ic3e/Begode-master/README.md

# Begode Master: front handle and self-levelling headlamp

3D-printable parts for the Begode Master electric unicycle:

- **Front handle:** built on the community handle (`reference/euc_master_front_handle.stl`), with every
  original bolt hole kept where it was, and a sealed USB-C phone charger in one leg.
- **Self-levelling headlamp:** fills the stock lamp's opening in the top cover. It has:
  - three fixed LEDs; a servo tilts a frame with their three lenses ±10°, so the beam stays put while the
    wheel pitches (about 1000–1100 lm)
  - a road sensor behind the window, so the beam follows hills too (an EUC stays level on a hill; the gyro alone
    can't see one)
  - two riding buttons on the handle's leg: dip the beam for oncoming traffic, high beam, flash
  - sealed against rain, tyre spray and sand: the cooling air has its own drained duct, everything else is dry
  - daytime running lights and day/night switching
  - two buttons in the chin for every setting, so no phone or app is needed (a Wi-Fi page is there if you want it)
  - a USB-C phone charger in the handle, with a power guard so the lamp and charger stay inside the wheel's lamp output
  - beam brightness that follows the wheel's lamp voltage (6.5 V dim, 12 V full)
  - a flush clear window and angled running-light lines that follow the Master's faceted front
  - drop-safe: whichever way the wheel falls, the handle, shells or tyre touch the ground first (lamp at least
    20 mm clear), and hard stops inside so a drop doesn't load the servo's gears

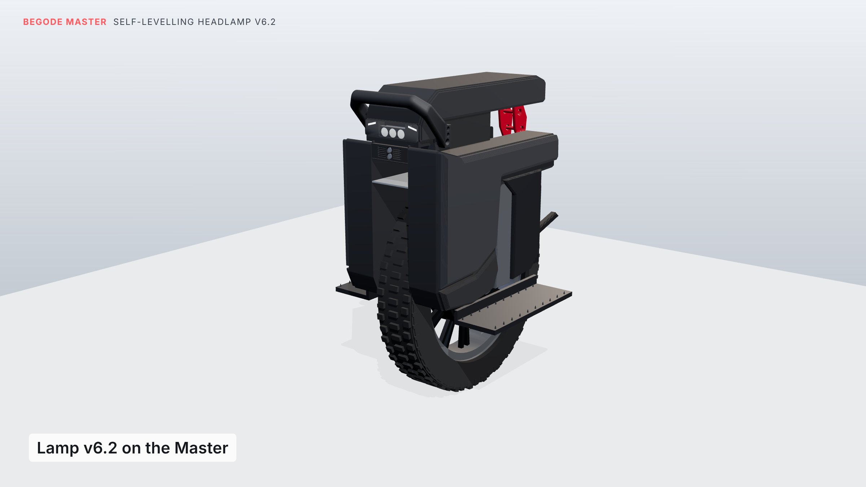
[picture p1: current/renders/render_v62_hero.png]
Lamp v6.2 in the stock opening

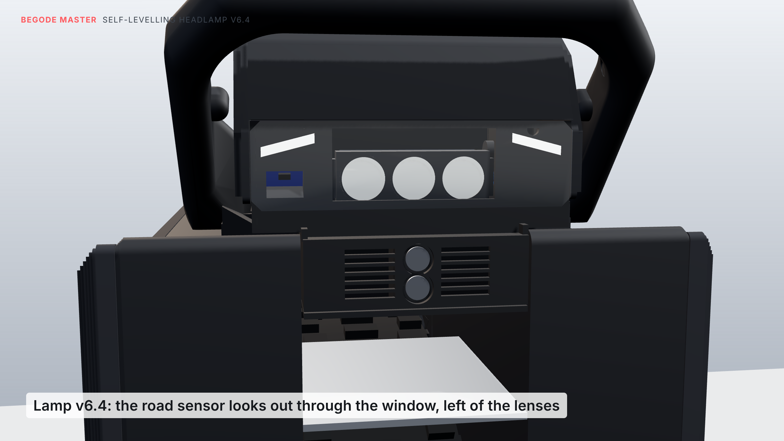
[picture p2: current/renders/render_v64_face.png]
Lamp v6.4: the road sensor's eye left of the lenses


## What to print now

Everything is in [`current/`](current). [`current/BUILD_GUIDE.md`](current/BUILD_GUIDE.md) has:

- the parts list
- which LEDs, optics, heat sink and electronics to buy, and the wiring
  (prices and shops in [`current/PARTS.md`](current/PARTS.md), about €115–170)
- hardware and assembly order
- the buttons (chin and handle) and the USB charger
- the firmware
- everything that was checked

[`current/TESTING.md`](current/TESTING.md) is the test plan and log for rides, rough roads, drops and rain.

| Folder | Contents |
|---|---|
| `current/stl/` | handle v18 (USB port and riding buttons on the right or left), the two bolt covers (right and left), lamp housing, top plate, lens frame, lid, and the window's cutting template (SVG), each lying on the bed as it should print |
| `current/firmware/headlamp6_firmware/` | ESP32-C3 firmware (Arduino; needs the Pololu "VL53L1X" library) |
| `current/renders/` | stills: day, night, face on, fallen forward / onto its side; how the head is fitted, the stops, the buttons and the USB port |
| `reference/` | the original handle and cap STLs, the measurement sheets, and [`MEASUREMENTS.md`](reference/MEASUREMENTS.md) (every measurement taken on the wheel) |
| `source/` | the Python scripts that build, check, export and render every version (see [`source/README.md`](source/README.md)) |
| `archive/` | all earlier versions: guides, STLs, firmware, renders, including v8 with the swing-up can holder and its animation |

**Only `current/` fits the real wheel.** Handles v4 to v9 were drawn on a wheel model traced from photos.
They run into the shells and the top cover, so don't print them. From v10 on, everything is checked
against a model built from caliper measurements.

## Version history

| Guide | Handle | What changed |
|---|---|---|
| — | v1 | cup ring that folds up beside the handle |
| — | v2 | cup ring on hinges at the handle's front corners |
| — | v3–v5 | motorcycle-style folding cup holder; holder for the stock lamp (estimated) |
| headlamp v1 | v5 | self-levelling servo head (ESP32-C3 + MPU-6050) |
| headlamp v2 | v5 | road sensor (VL53L1X), daytime running lights, light sensor, Wi-Fi settings |
| headlamp v3 | v6 | follows the wheel's 6.5 / 12 V lamp output; lamp and cup holder as one unit |
| v4 | v7 | minimal ring that folds under the lamp, with a fold-flat foot |
| v5 | v8 | slide-out self-levelling cup holder (forward/back) |
| v6 | v9 | two-axis gimbal (forward/back and side to side) |
| v7 | v10 | rebuilt to caliper measurements; lamp in front of the cover; can holder swings up into the bay |
| v8 | v11 | lamp built into the stock lamp opening; extra mounting through the cover's two M4 screws |
| lamp v5 | v12 | no can holder; three LEDs on one tilting bar (~1200 lm); electronics box between the shells |
| lamp v5.1 | v12 | flush polycarbonate window, angled running-light lines, chin vent and baffle, checked for drops |
| lamp v5.2 | v12 | open-top housing with a screwed-on top plate, so the head and servo can actually be fitted |
| lamp v5.3 | v12 | sealed 6800 ball bearing for the head's pivot; wire hole on the pin's axis |
| lamp v5.4 | v13 | hard stops for the head; chin buttons instead of the phone page; USB-C charger in the handle with a power guard; firmware v6 |
| lamp v6 | v13 | sealed against rain, tyre spray and sand: LEDs fixed on a heat sink in a separate air duct, only a lens frame tilts |
| lamp v6.1 | v13 | fewer parts: no road sensor, no heat-sink clamp, no diffusers, no gasket |
| lamp v6.2 | v14 | ready for the slicer: no thin walls, slits or trapped supports; parts exported in their print orientation; horn glued |
| lamp v6.2 | v15 | the USB-C port flush in the handle's leg, no bump: a bare receptacle potted in epoxy, with a silicone plug |
| lamp v6.2 | v16 | the USB-C port on the leg's inside, out of the way in a side fall; pressed in from inside, no pocket to fill |
| lamp v6.2 | v17 | the lamp tabs braced (the first print snapped them): a gusset under each and a fillet over its root; the USB wire inside the root, not in a groove along it |
| lamp v6.3 | v17 | every board fitted at its real size; wire slots from the side bays into the electronics box; wiring diagram and board renders |
| **lamp v6.4** | **v18** | **a road sensor (VL53L1X) behind the window so the beam follows hills; two riding buttons on the handle's leg that dip, raise and flash the beam (cut-off lenses don't fit the opening)** |

## Rebuilding

Python 3 with `numpy`, `trimesh`, `manifold3d` and `matplotlib`. Run from `source/`:

```
cd source && mkdir -p ../build_output
python3 check28.py     # every fit / clearance / assembly / sealing / drop check for the current version
python3 export28.py    # writes the current STLs and the window SVG to current/stl/, lying as they print
python3 boards_pack.py # fits the boards into the dry spaces (then boards_export.py, wiring_diagram.py)
python3 print_check.py # what a slicer would see in them: closed solids, thin walls, slits, supports
```

Stills (three.js in headless Chromium, as for the animation):

```
python3 stills6_export.py              # writes anim/stills6_data.js
cd anim && npm install
python3 -m http.server 8766 --bind 127.0.0.1 &
PAGE=stills6.html OUTD=stills6 node stills_render.mjs   # anim/stills6/f0000.png …
```

To re-render the v8 animation, see `source/README.md`.

Coordinates throughout are the handle STL's own frame: −X forward, +Y up, Z across the wheel (centre Z = −70.5).
