ic3e/Begode-master/current/renders/boards_4.png

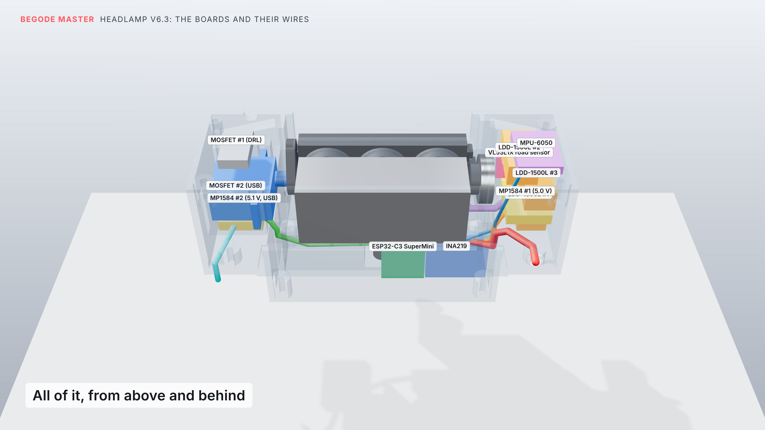
current/renders/boards_4.png
