ic3e/Begode-master/current/renders/concept_projector_rig.png

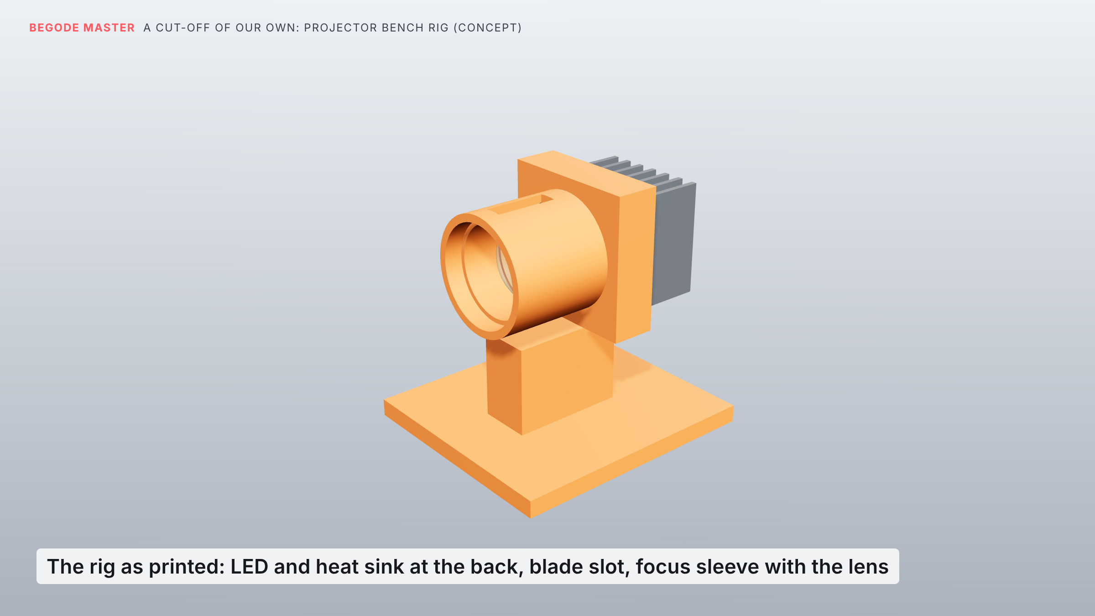
current/renders/concept_projector_rig.png
