ic3e/Begode-master/current/renders/level_accelerating.png

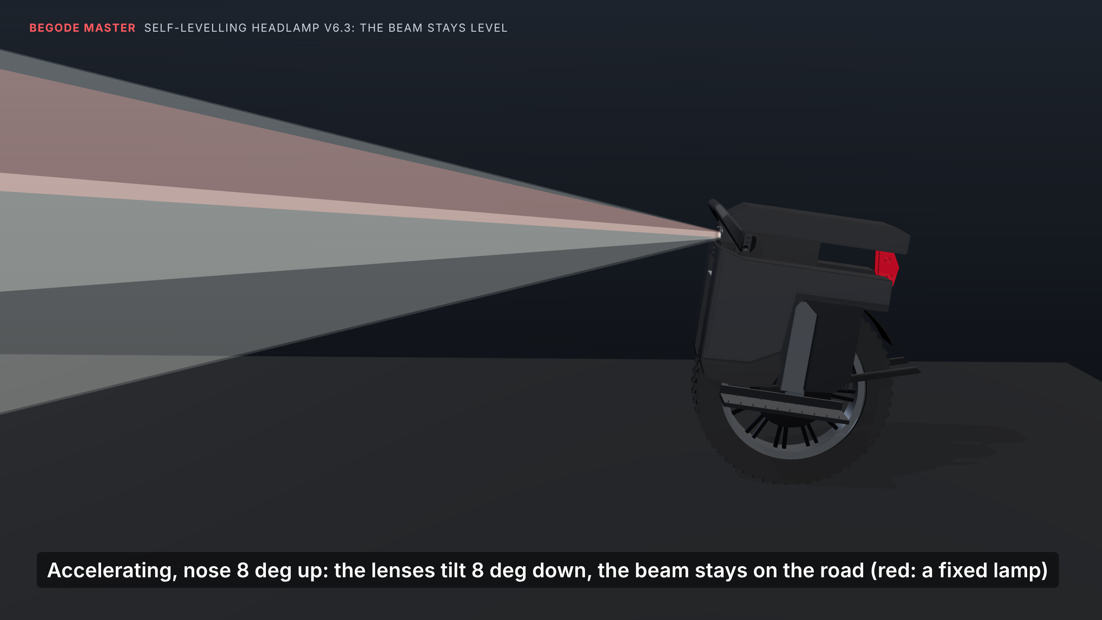
current/renders/level_accelerating.png
