ic3e/Begode-master/current/renders/level_riding.png

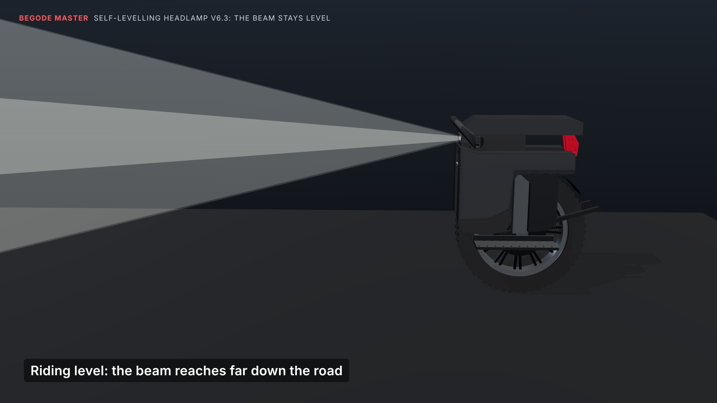
current/renders/level_riding.png
