ic3e/Begode-master/current/renders/render_v8_front.png

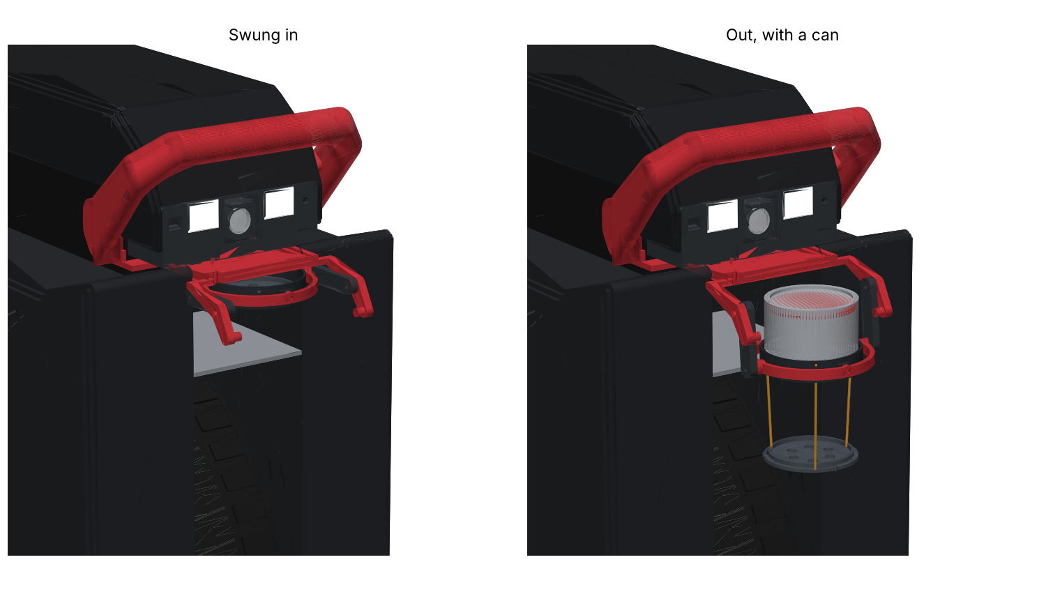
current/renders/render_v8_front.png
