ic3e/Begode-master/current/renders/render_v8_lean.png

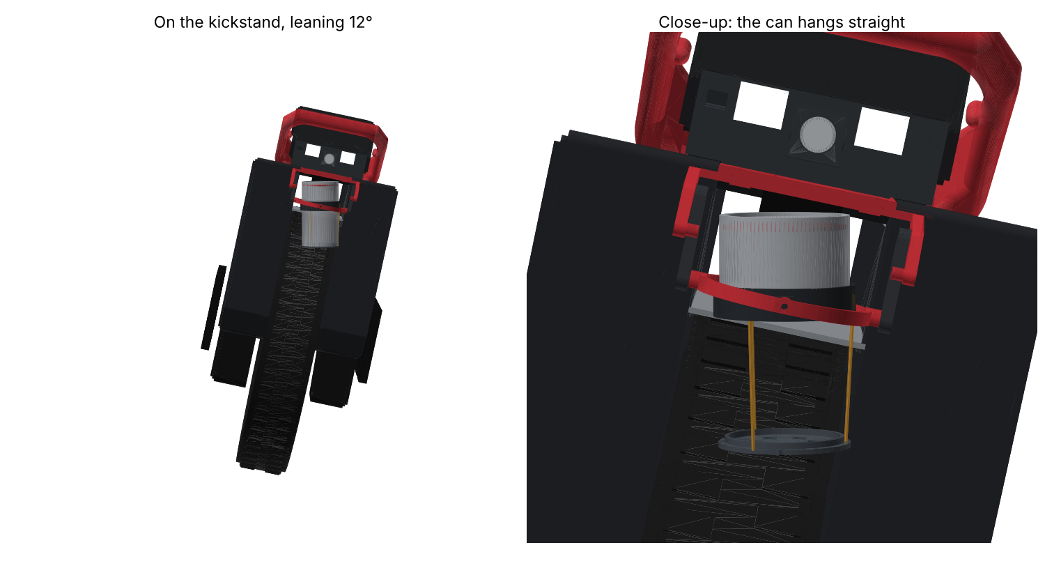
current/renders/render_v8_lean.png
