ic3e/Begode-master/current/renders/render_v8_side.png

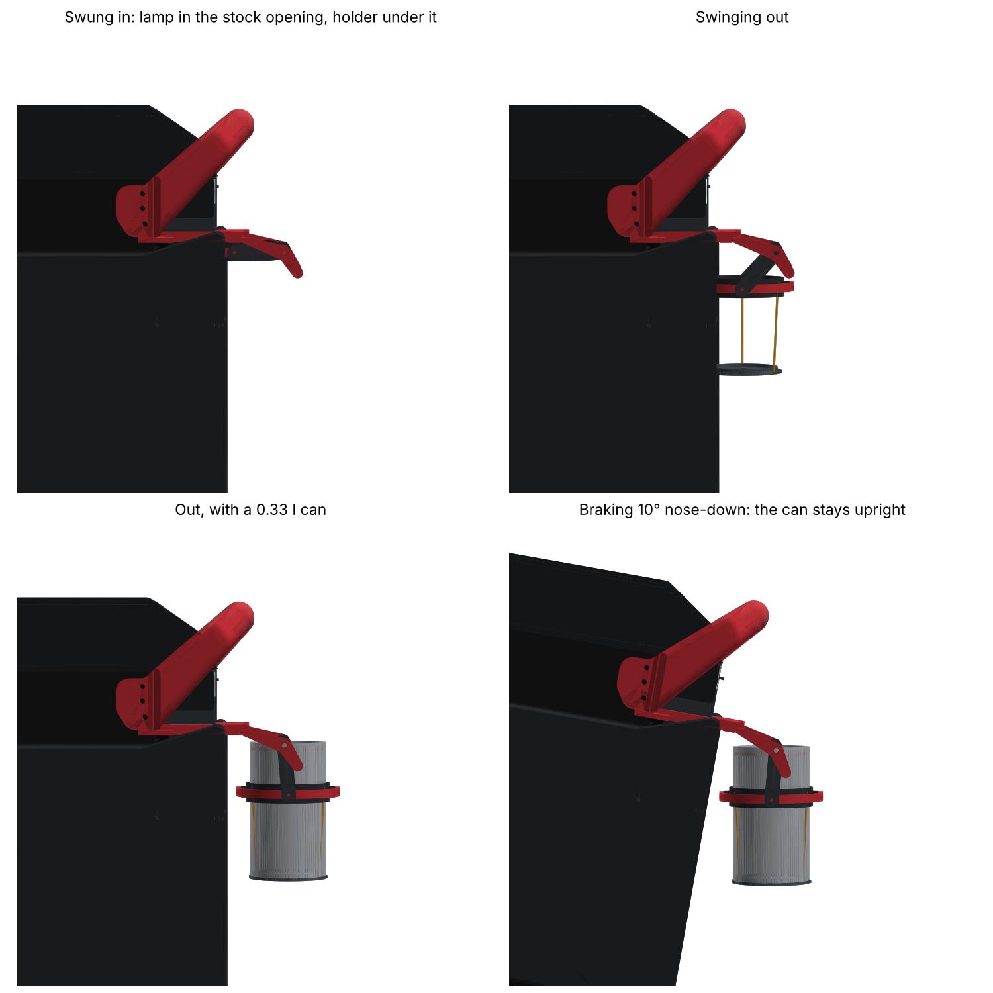
current/renders/render_v8_side.png
