ic3e/Begode-master/current/renders/render_v9_lamp.png

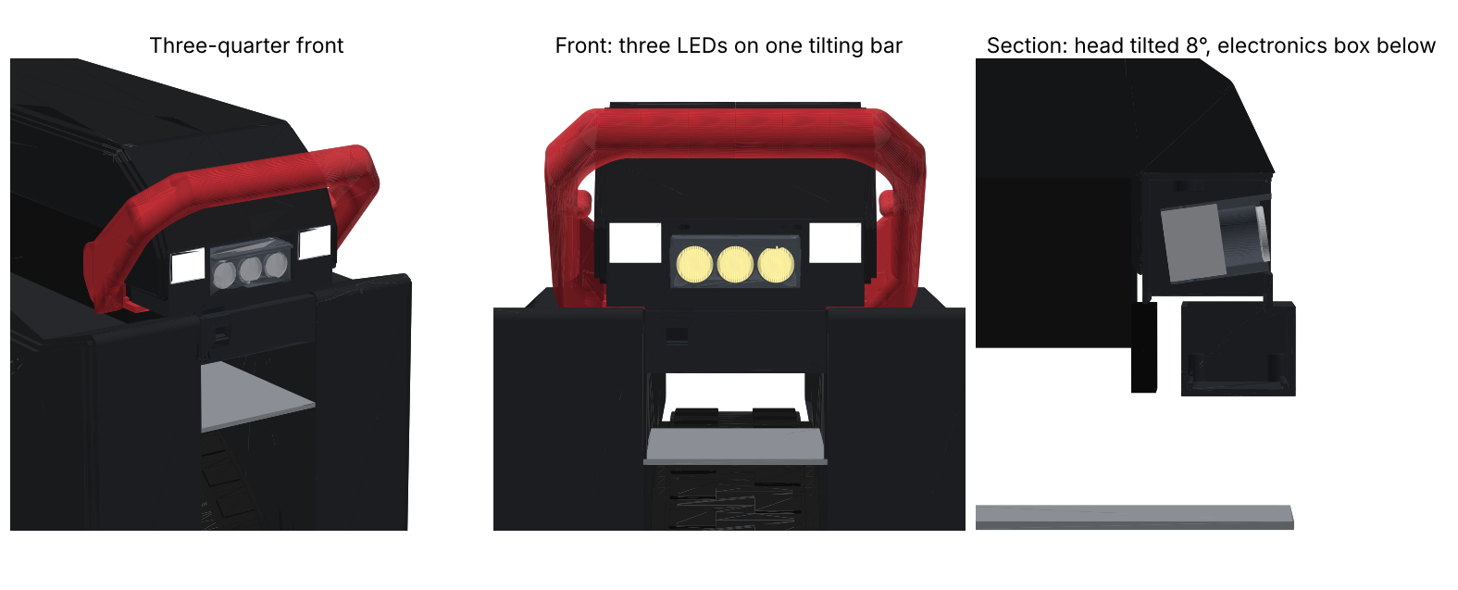
current/renders/render_v9_lamp.png
