ic3e/Begode-master/current/renders/render_v51_closeup.png

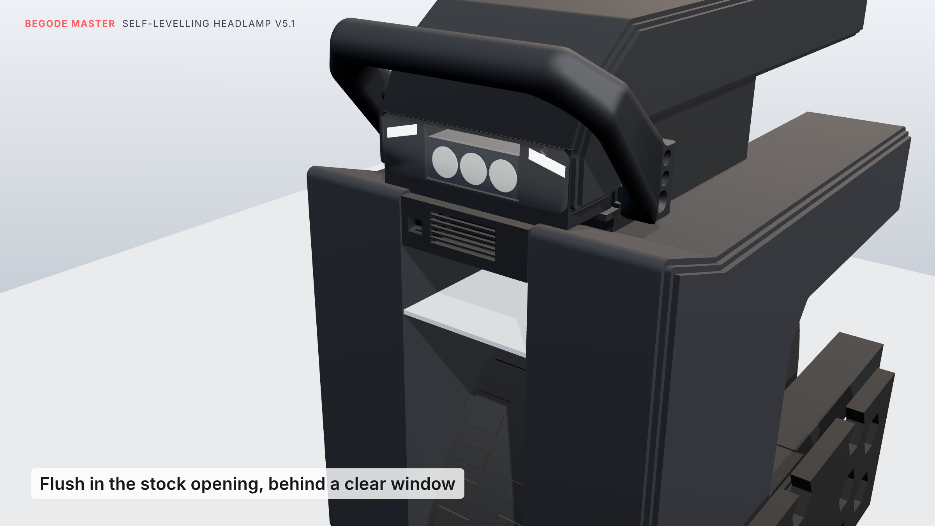
current/renders/render_v51_closeup.png
