ic3e/Begode-master/current/renders/render_v51_face.png

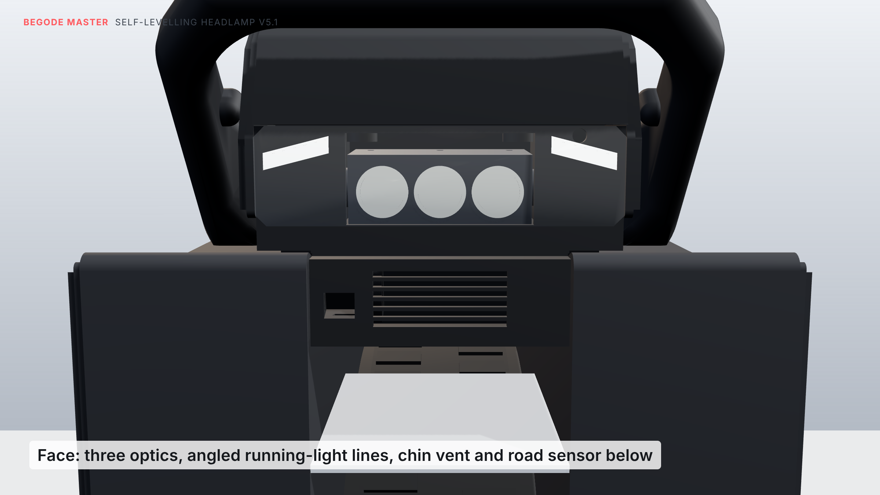
current/renders/render_v51_face.png
