ic3e/Begode-master/current/renders/render_v51_fallen_forward.png

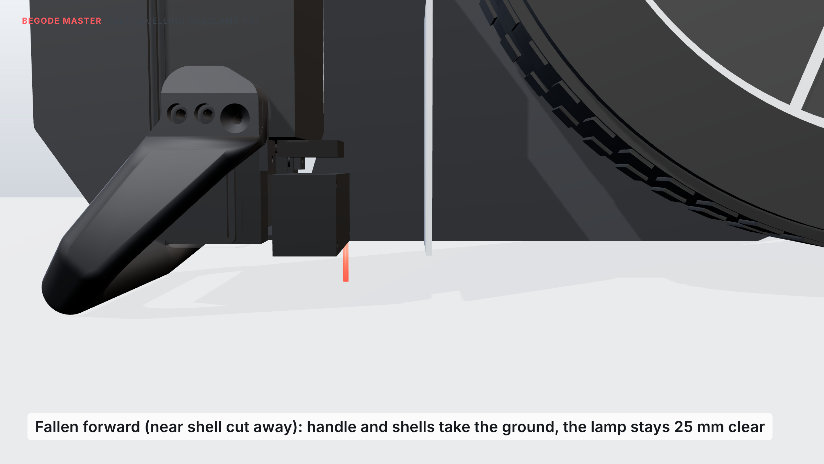
current/renders/render_v51_fallen_forward.png
