ic3e/Begode-master/current/renders/render_v51_fallen_side.png

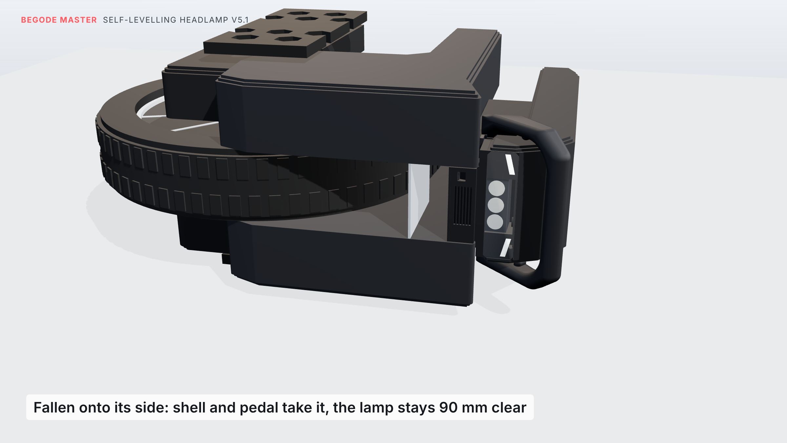
current/renders/render_v51_fallen_side.png
