ic3e/Begode-master/current/renders/render_v51_night.png

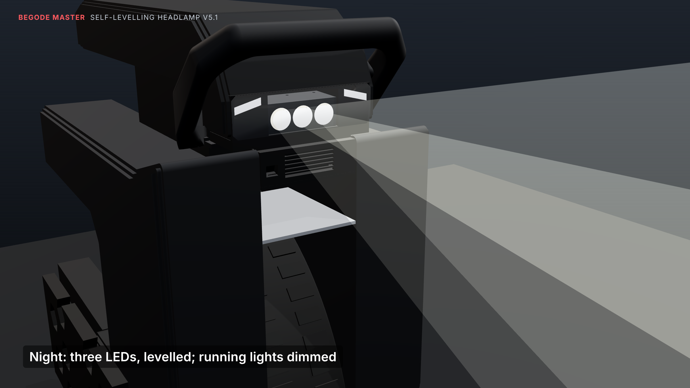
current/renders/render_v51_night.png
