ic3e/Begode-master/current/renders/render_v52_mechanism_3.png

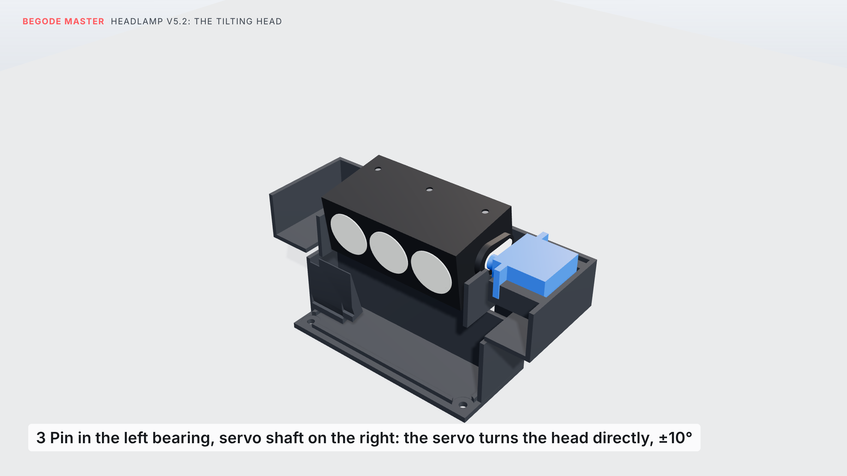
current/renders/render_v52_mechanism_3.png
