ic3e/Begode-master/current/renders/render_v54_mechanism_4.png

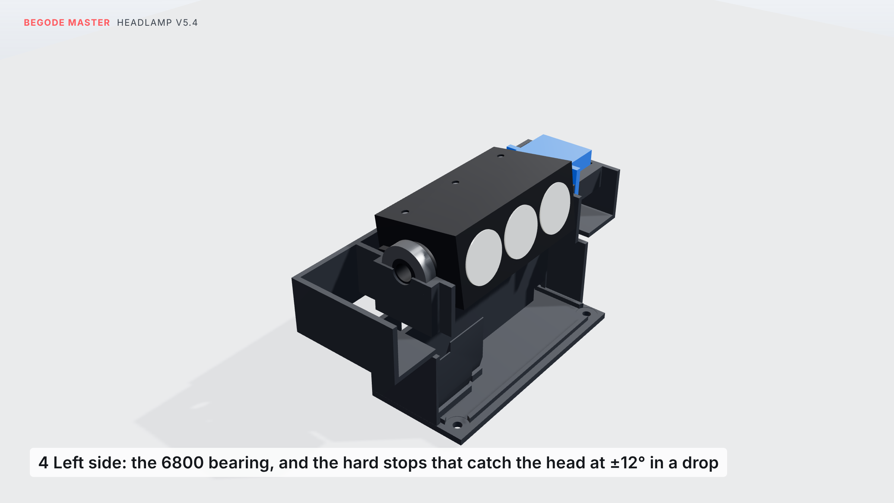
current/renders/render_v54_mechanism_4.png
