ic3e/Begode-master/current/renders/render_v54_mechanism_5.png

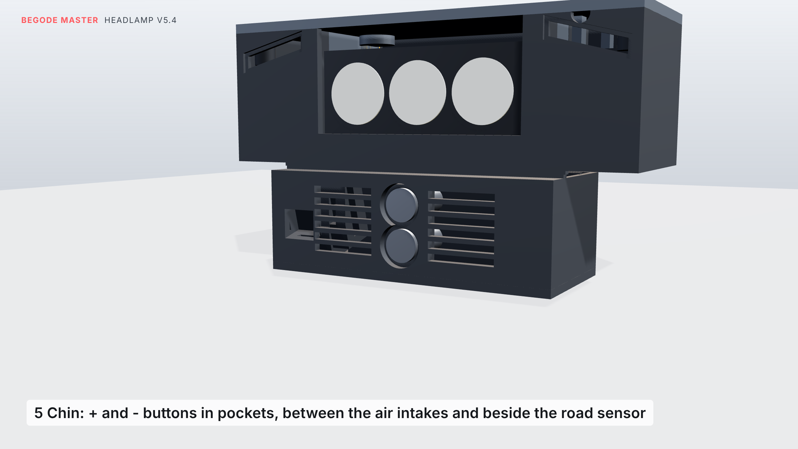
current/renders/render_v54_mechanism_5.png
