ic3e/Begode-master/current/renders/render_v54_mechanism_6.png

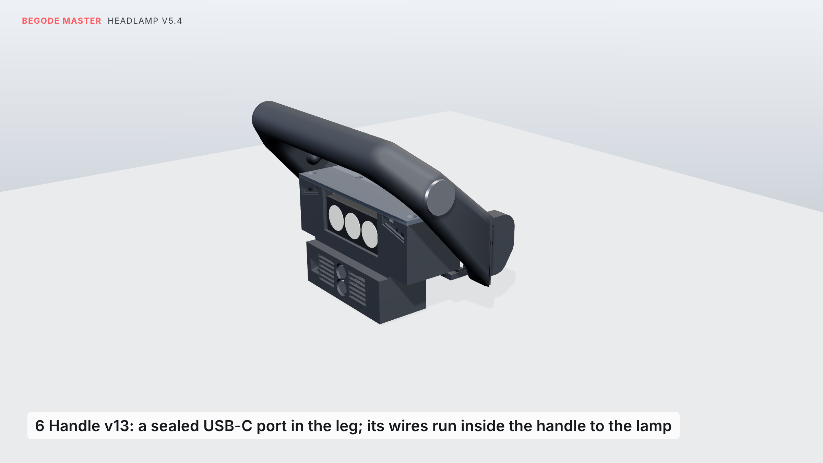
current/renders/render_v54_mechanism_6.png
