ic3e/Begode-master/current/renders/render_v54_mechanism_7.png

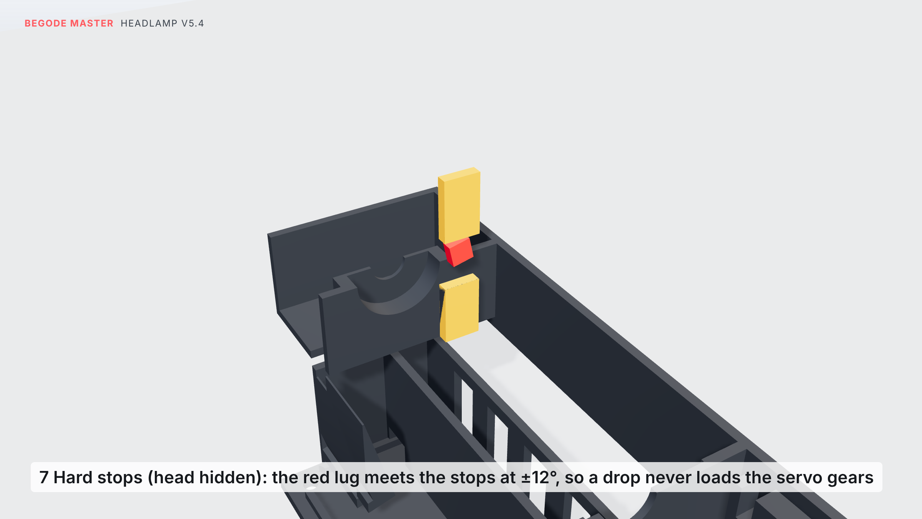
current/renders/render_v54_mechanism_7.png
