ic3e/Begode-master/current/renders/render_v60_1.png

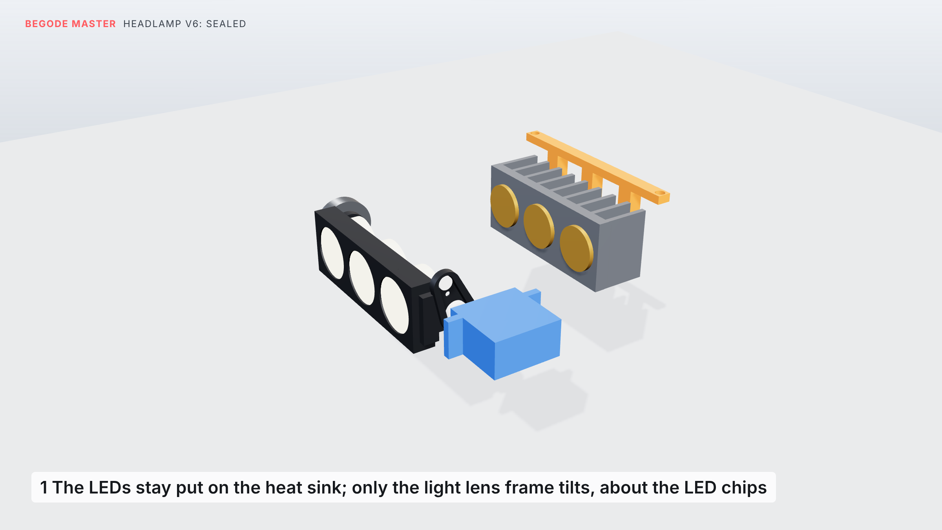
current/renders/render_v60_1.png
