ic3e/Begode-master/current/renders/render_v60_2.png

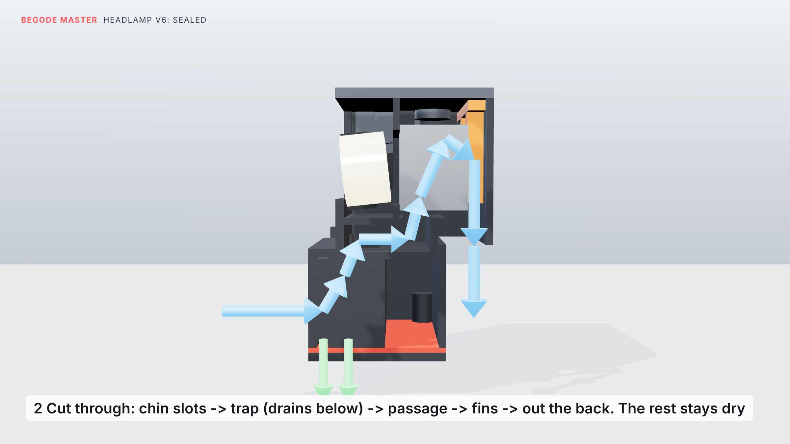
current/renders/render_v60_2.png
