ic3e/Begode-master/current/renders/render_v60_3.png

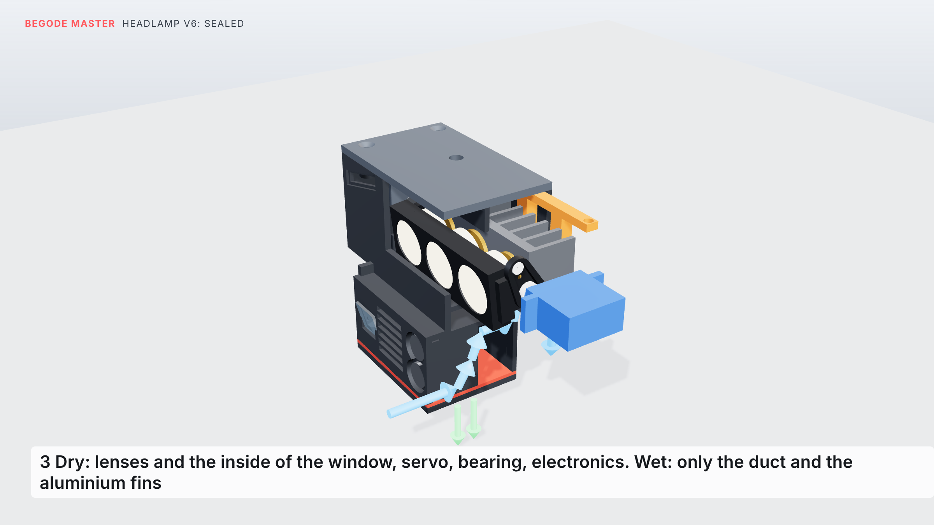
current/renders/render_v60_3.png
