ic3e/Begode-master/current/renders/render_v60_5.png

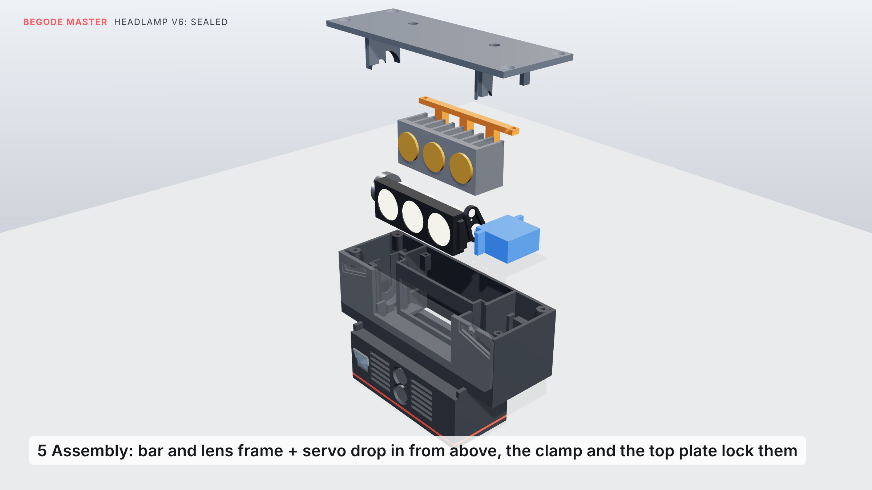
current/renders/render_v60_5.png
