ic3e/Begode-master/current/renders/render_v61_2.png

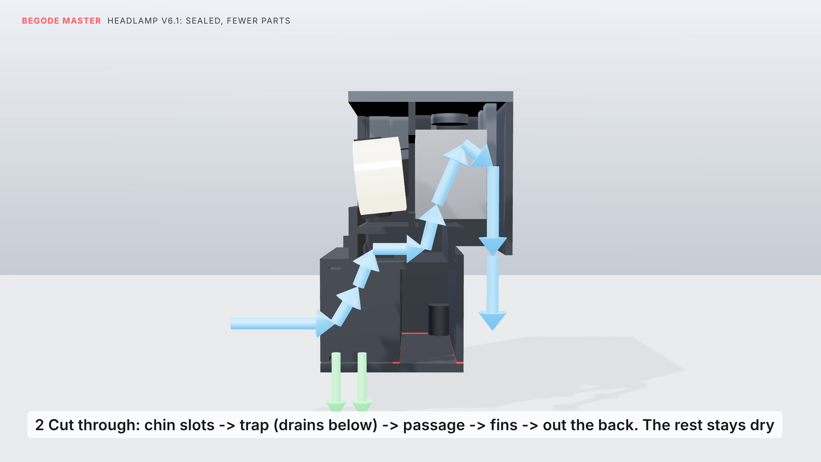
current/renders/render_v61_2.png
