ic3e/Begode-master/current/renders/render_v61_4.png

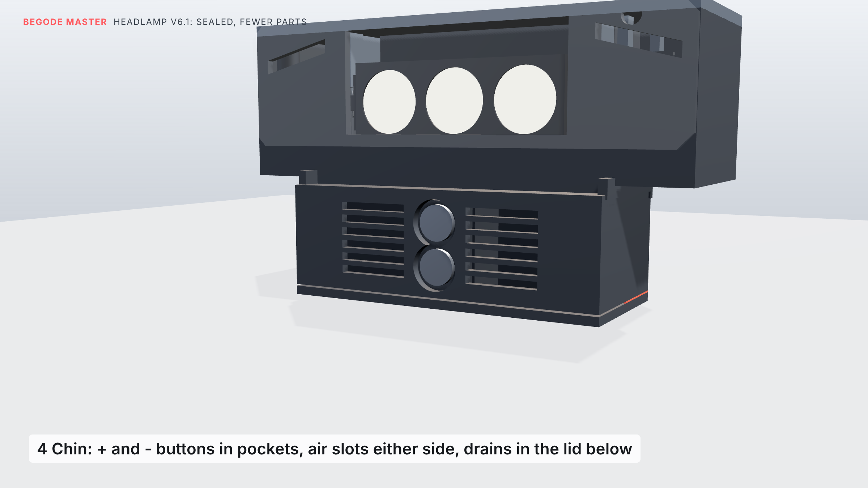
current/renders/render_v61_4.png
