ic3e/Begode-master/current/renders/render_v61_5.png

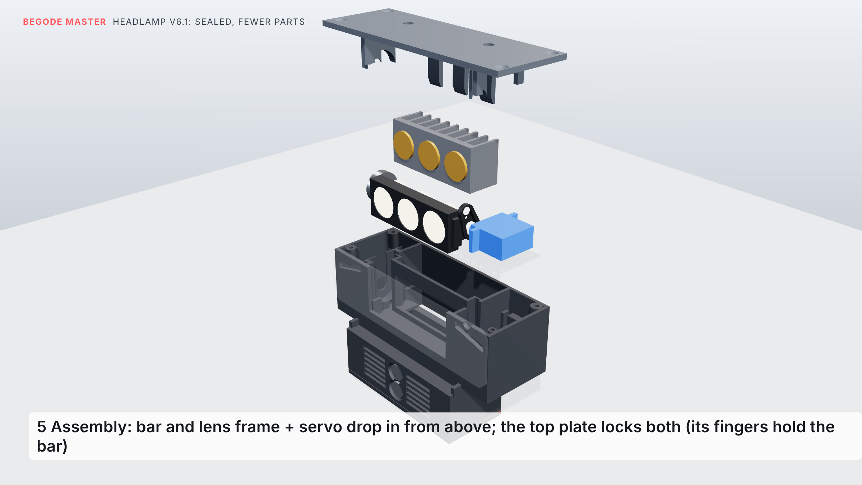
current/renders/render_v61_5.png
