ic3e/Begode-master/current/renders/render_v61_closeup.png

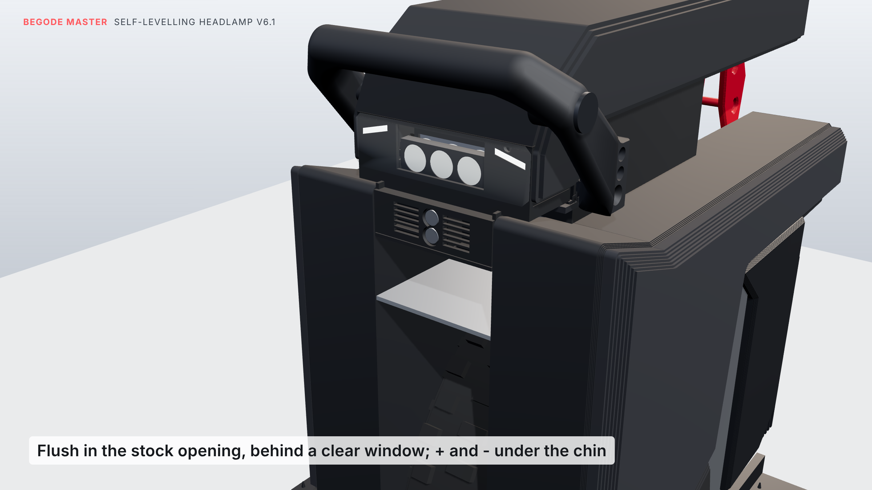
current/renders/render_v61_closeup.png
