ic3e/Begode-master/current/renders/render_v61_face.png

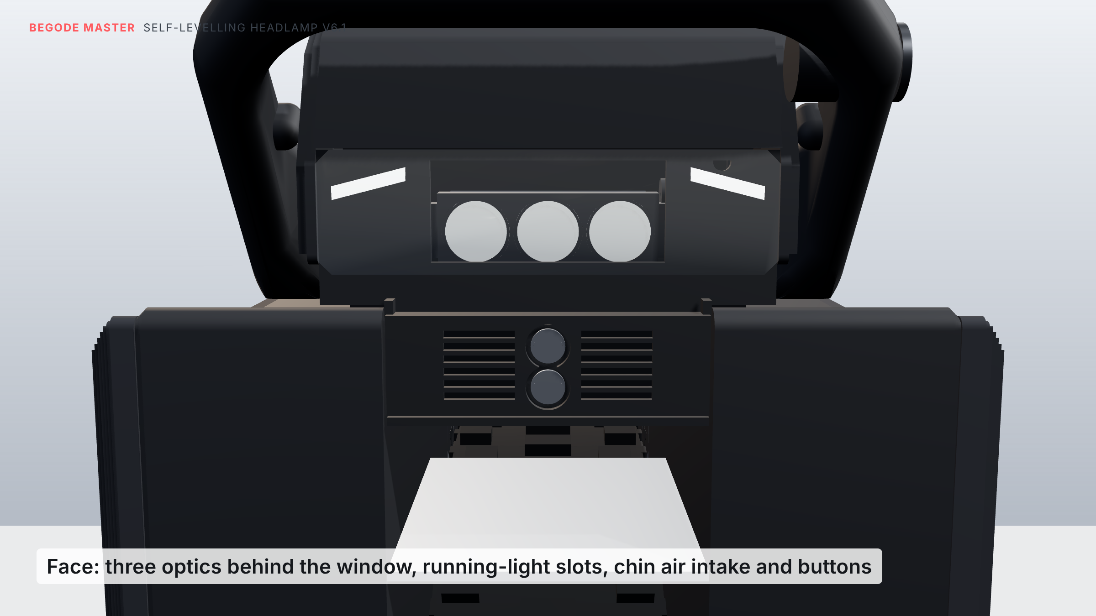
current/renders/render_v61_face.png
