ic3e/Begode-master/current/renders/render_v61_fallen_forward.png

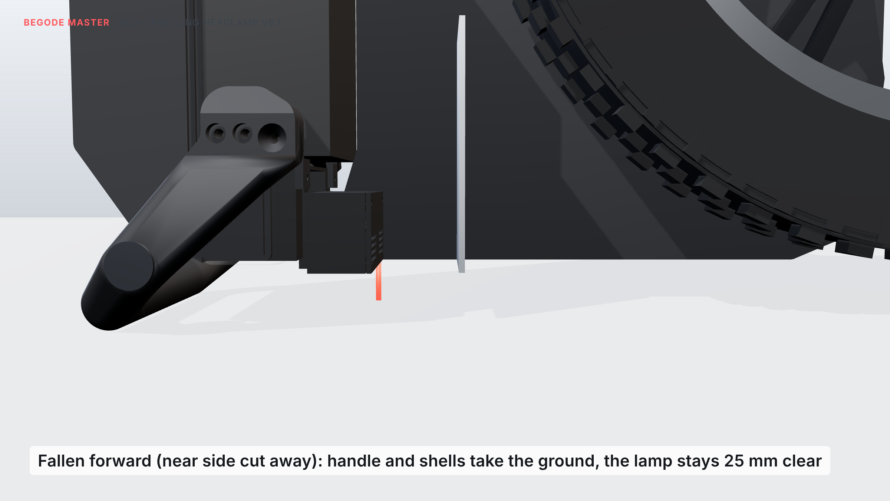
current/renders/render_v61_fallen_forward.png
