ic3e/Begode-master/current/renders/render_v62_5.png

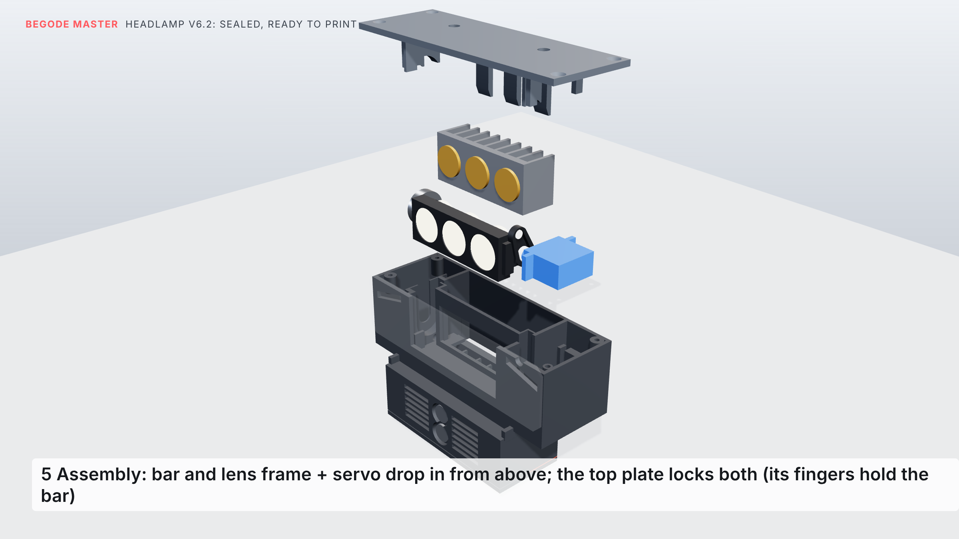
current/renders/render_v62_5.png
