ic3e/Begode-master/current/renders/render_v64_night.png

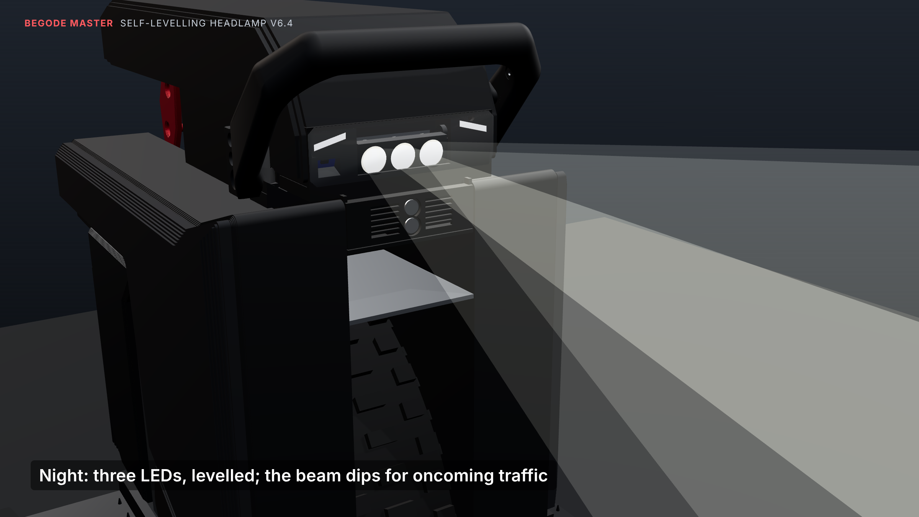
current/renders/render_v64_night.png
