ic3e/Begode-master/current/renders/rider_pov.gif

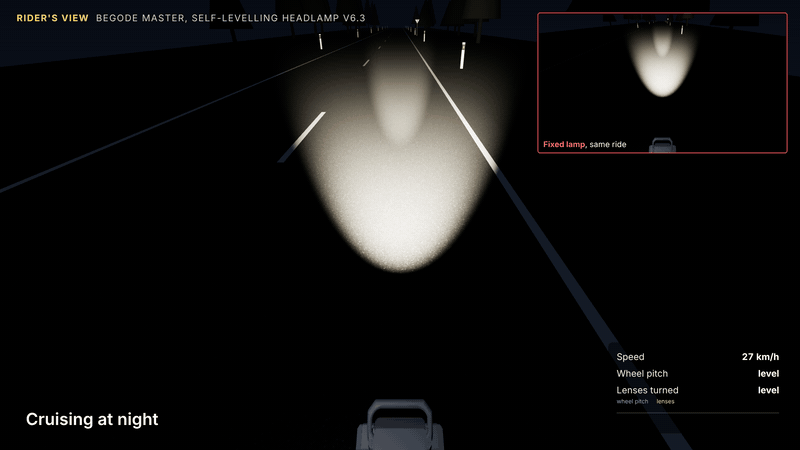
current/renders/rider_pov.gif
