ic3e/Begode-master/current/renders/tilt_down.png

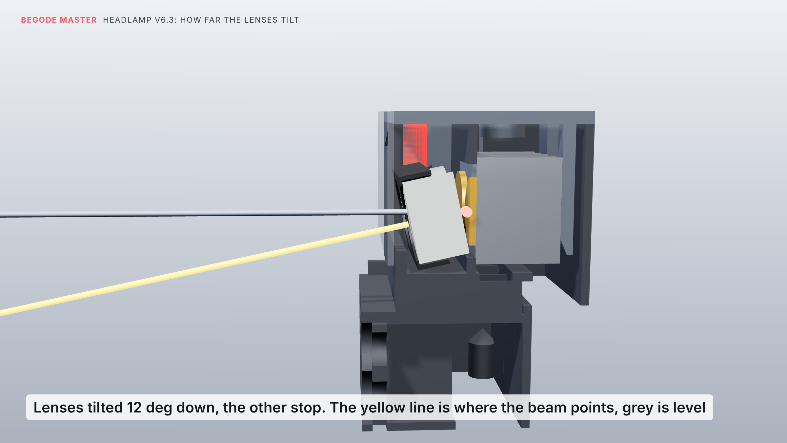
current/renders/tilt_down.png
