ic3e/Begode-master/current/renders/tilt_level.png

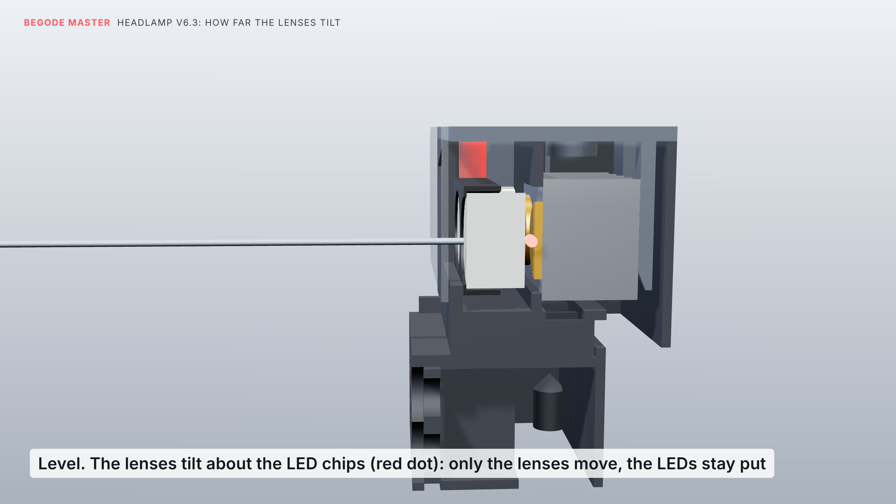
current/renders/tilt_level.png
