ic3e/Begode-master/current/stl/master_handle_v18_left.stl

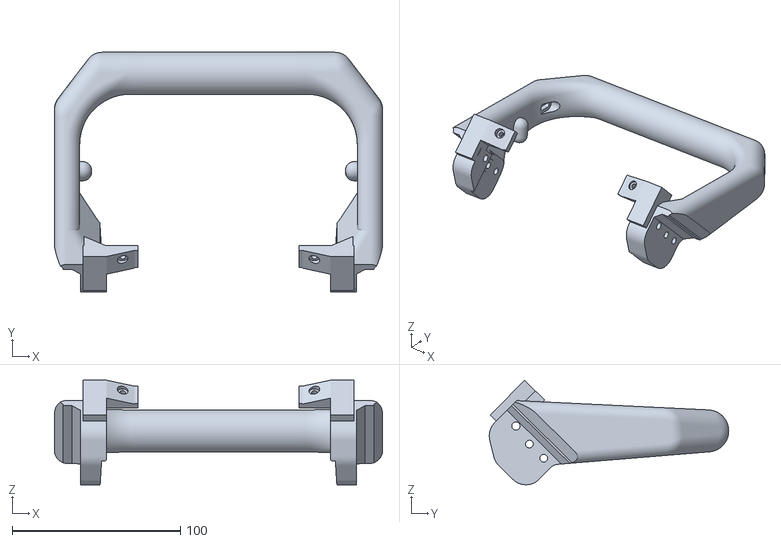
[picture p40: CAD file, 2026-10-23]
current/stl/master_handle_v18_left.stl
195.0 x 142.4 x 62.2
