ic3e/Begode-master/reference/euc_master_front_handle.stl

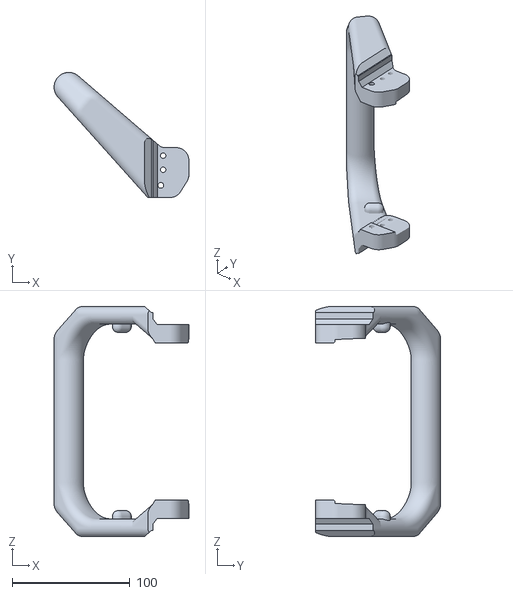
[picture p41: CAD file, 2026-10-22]
reference/euc_master_front_handle.stl
114.4 x 106.1 x 195.0
