ic3e/Begode-master/reference/euc_master_front_handle_p2.stl

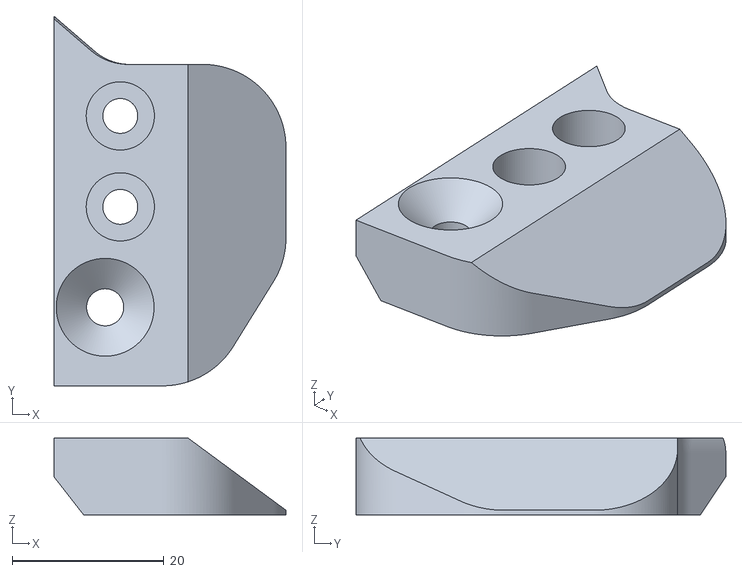
[picture p42: CAD file, 2026-10-22]
reference/euc_master_front_handle_p2.stl
30.6 x 48.8 x 10.1
