ic3e/Begode-master/current/stl/lamp64_housing.stl

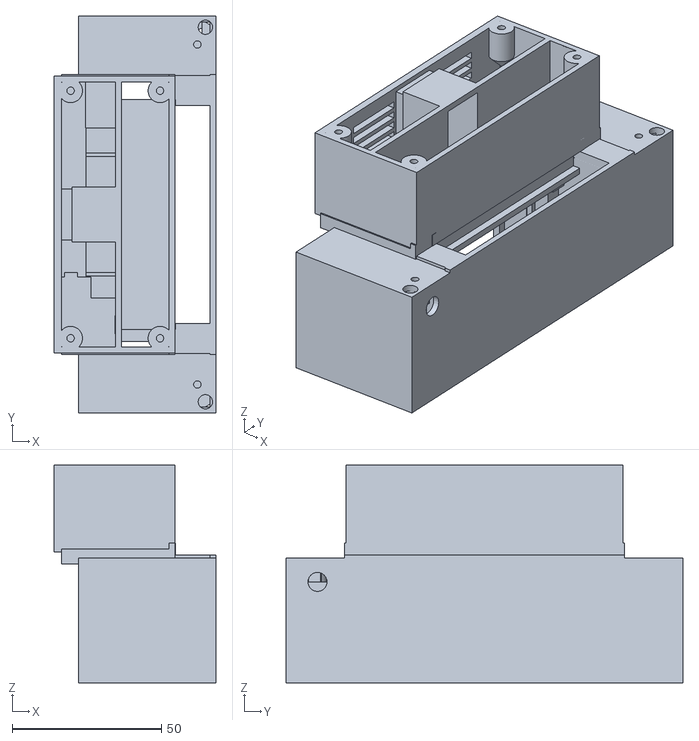
[picture p43: CAD file, 2026-10-23]
current/stl/lamp64_housing.stl
54.2 x 133.0 x 73.1
