ic3e/Begode-master/current/stl/master_handle_v17_usb_left.stl

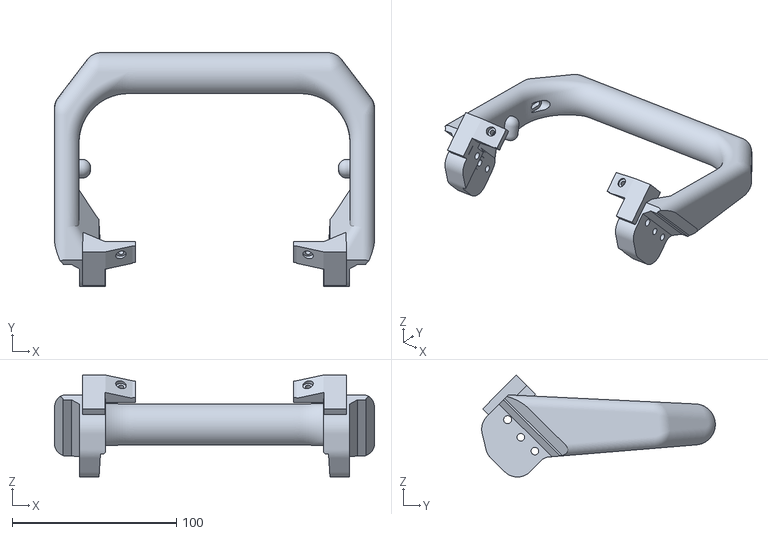
[picture p44: CAD file, 2026-10-22]
current/stl/master_handle_v17_usb_left.stl
195.0 x 142.4 x 62.2
