ic3e/Begode-master/current/stl/lamp64_top_plate.stl

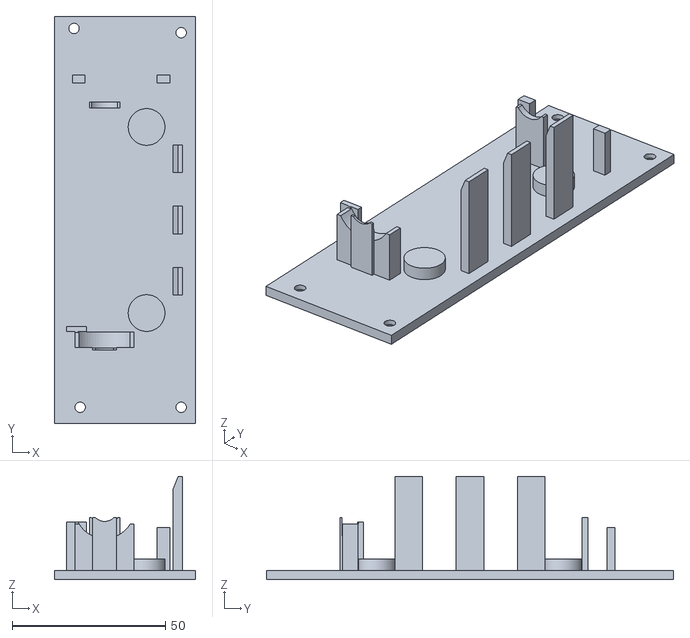
[picture p45: CAD file, 2026-10-22]
current/stl/lamp64_top_plate.stl
46.1 x 133.0 x 33.7
