ic3e/Begode-master/current/stl/lamp64_lid.stl

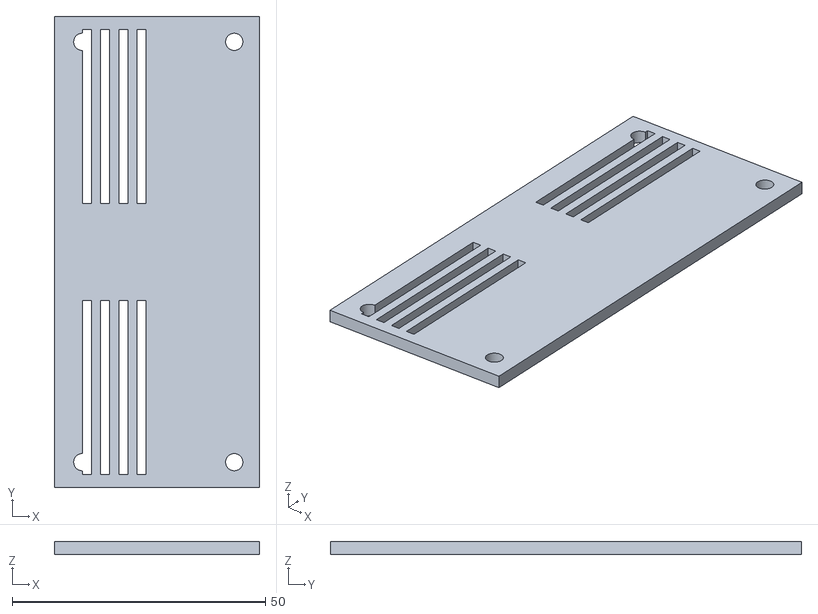
[picture p46: CAD file, 2026-10-22]
current/stl/lamp64_lid.stl
40.5 x 93.0 x 2.50
