ic3e/Begode-master/current/stl/lamp60_housing.stl

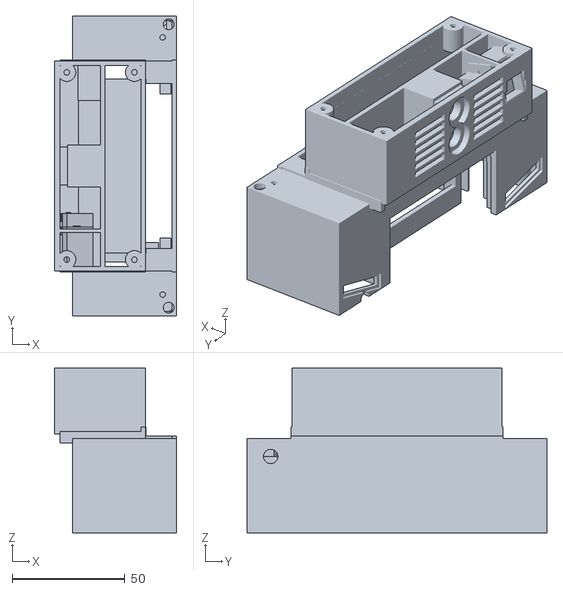
[picture p49: CAD file, 2026-10-22]
current/stl/lamp60_housing.stl
54.2 x 133.0 x 73.1
