ic3e/Begode-master/current/stl/lamp60_top_plate.stl

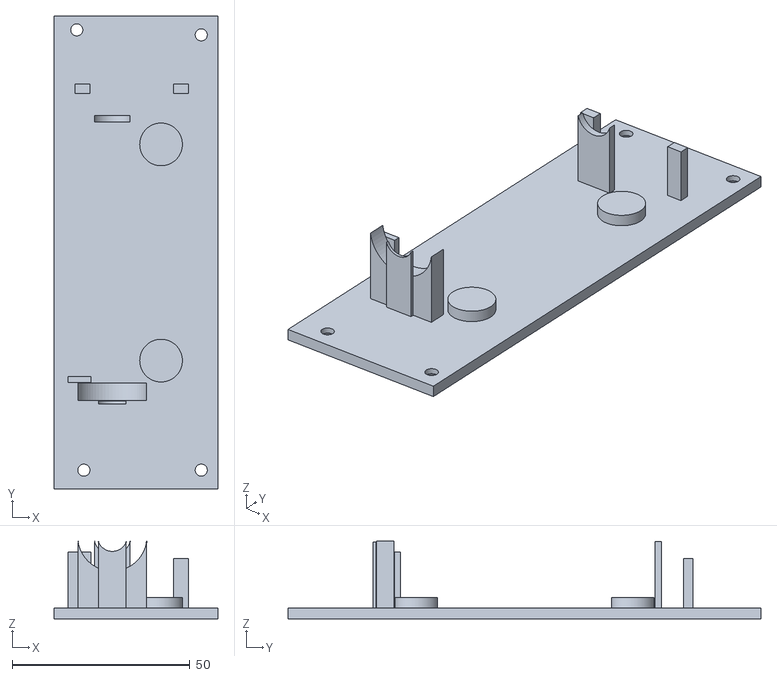
[picture p50: CAD file, 2026-10-22]
current/stl/lamp60_top_plate.stl
46.1 x 133.0 x 21.9
