ic3e/Begode-master/current/stl/lamp60_gasket_TPU.stl

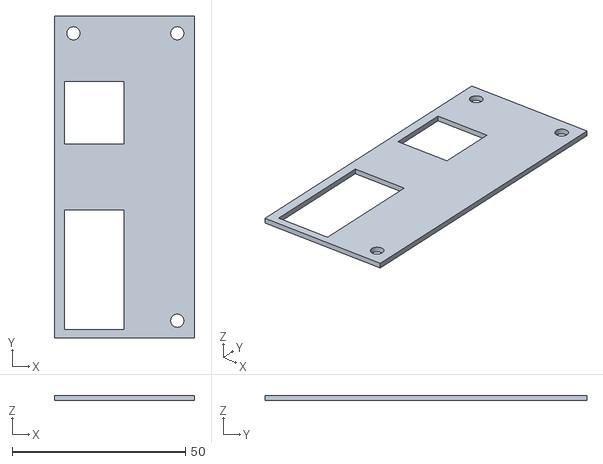
[picture p51: CAD file, 2026-10-22]
current/stl/lamp60_gasket_TPU.stl
40.5 x 93.0 x 1.50
