ic3e/Begode-master/current/stl/lamp60_bar_clamp.stl

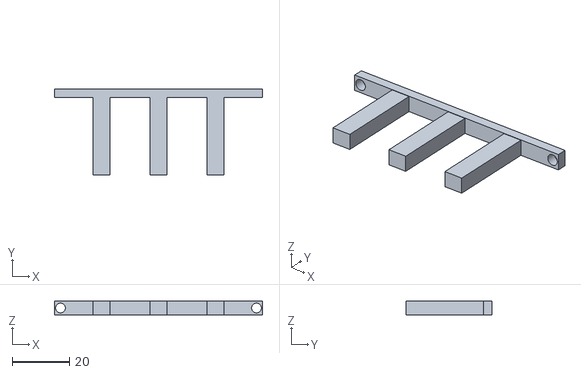
[picture p52: CAD file, 2026-10-22]
current/stl/lamp60_bar_clamp.stl
72.8 x 30.1 x 5.00
