ic3e/Begode-master/current/stl/lamp61_lens_frame.stl

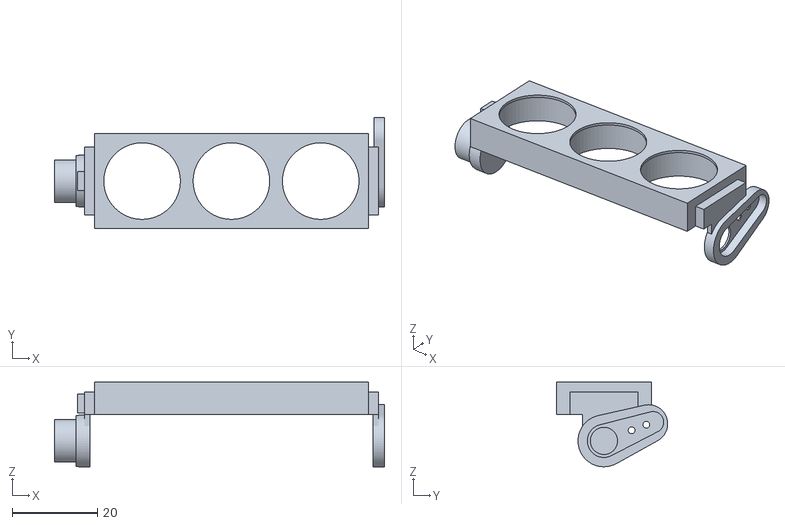
[picture p54: CAD file, 2026-10-22]
current/stl/lamp61_lens_frame.stl
77.6 x 26.2 x 19.9
