ic3e/Begode-master/current/stl/lamp54_head.stl

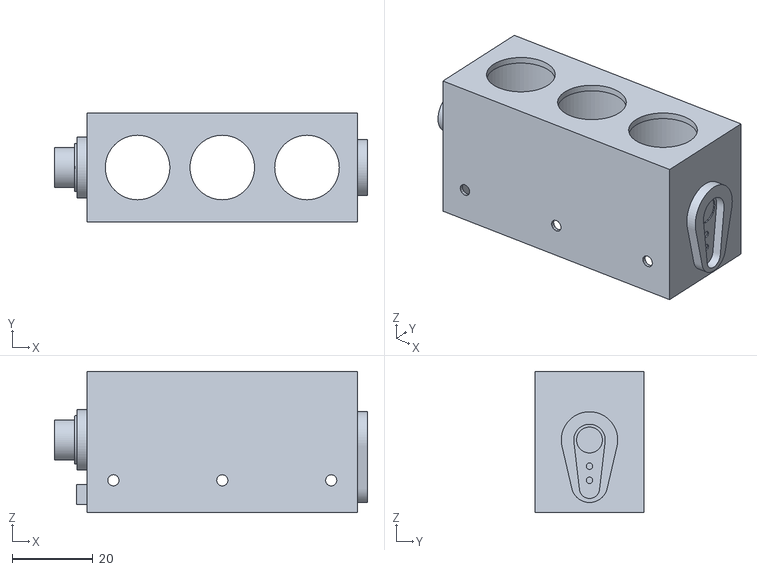
[picture p55: CAD file, 2026-10-22]
current/stl/lamp54_head.stl
77.6 x 27.0 x 35.0
