ic3e/Begode-master/current/stl/lamp54_lid.stl

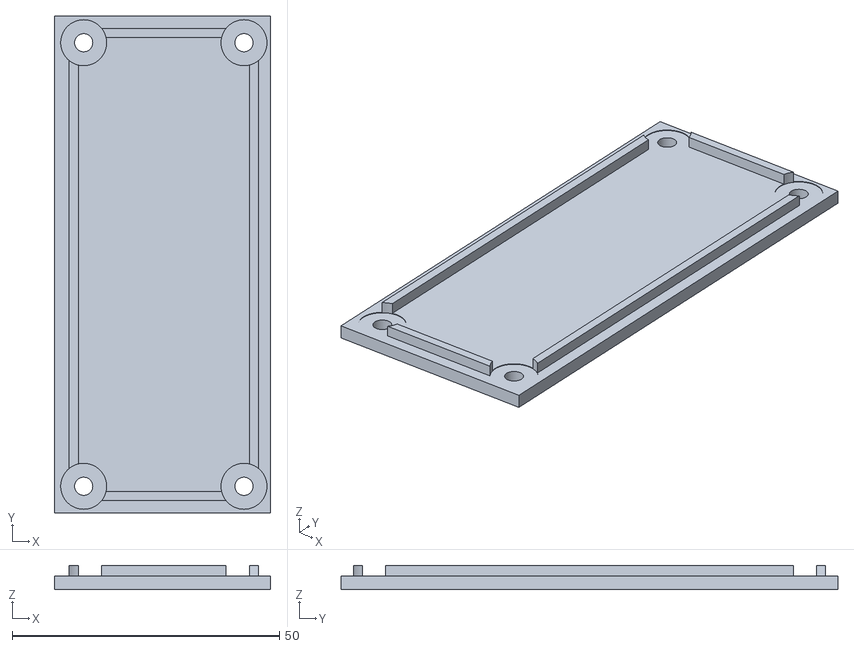
[picture p57: CAD file, 2026-10-22]
current/stl/lamp54_lid.stl
40.5 x 93.0 x 4.50
