ic3e/Begode-master/current/stl/lamp52_head.stl

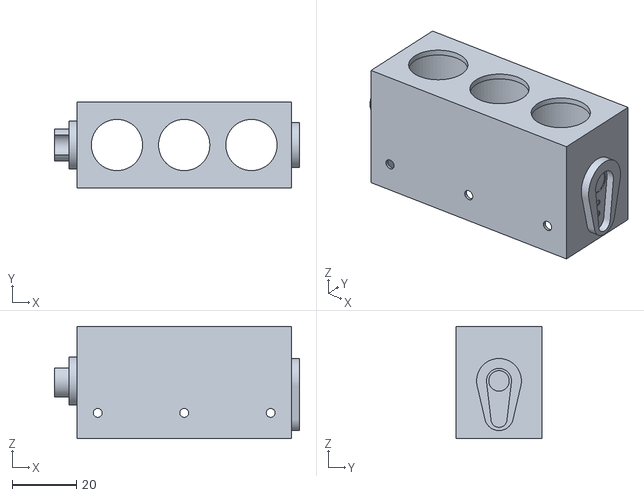
[picture p60: CAD file, 2026-10-22]
current/stl/lamp52_head.stl
76.5 x 27.0 x 35.0
