ic3e/Begode-master/current/stl/lamp60_drl_diffuser_right.stl

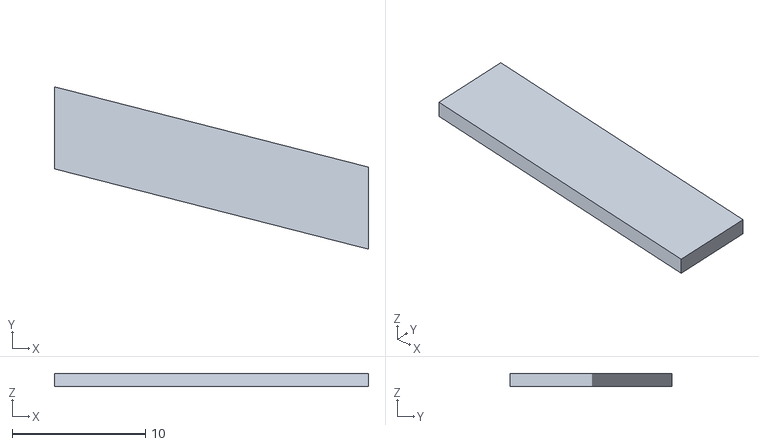
[picture p61: CAD file, 2026-10-22]
current/stl/lamp60_drl_diffuser_right.stl
23.6 x 12.2 x 1.00
