ic3e/Begode-master/current/stl/lamp5_housing.stl

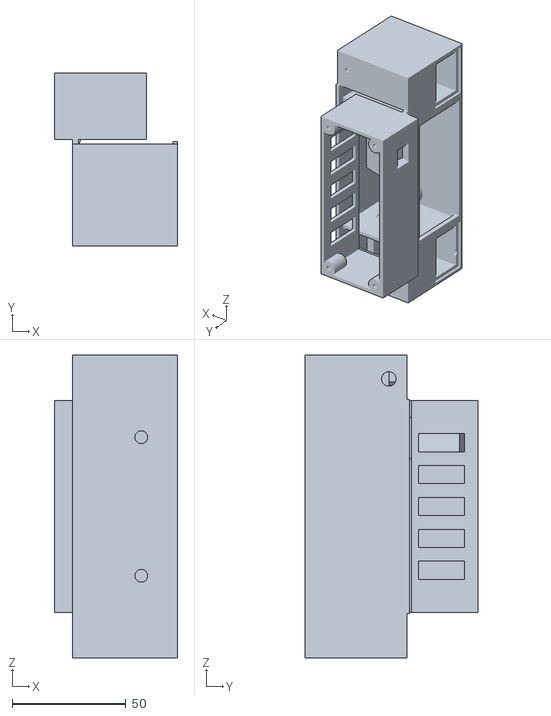
[picture p63: CAD file, 2026-10-22]
current/stl/lamp5_housing.stl
54.2 x 76.1 x 133.0
