ic3e/Begode-master/current/stl/master_handle_v12.stl

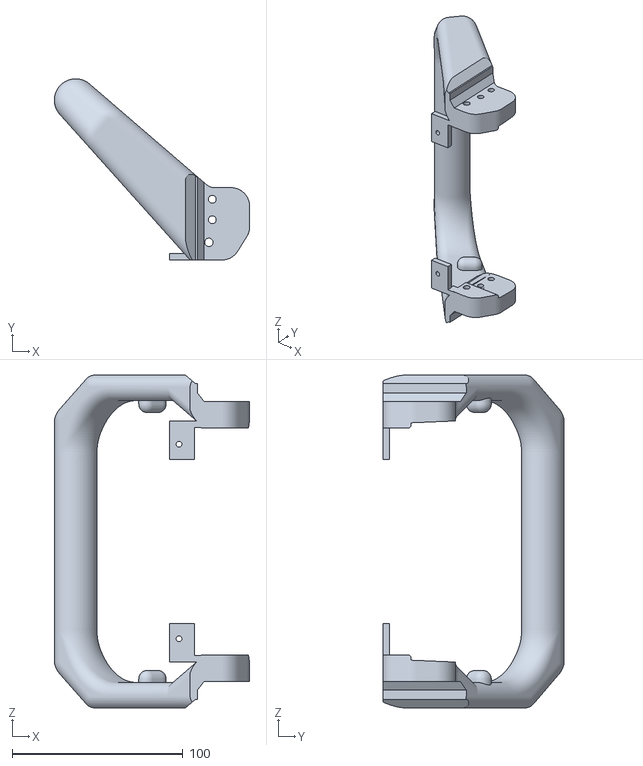
[picture p64: CAD file, 2026-10-22]
current/stl/master_handle_v12.stl
114.4 x 106.2 x 195.0
