ic3e/Begode-master/current/stl/lamp5_head.stl

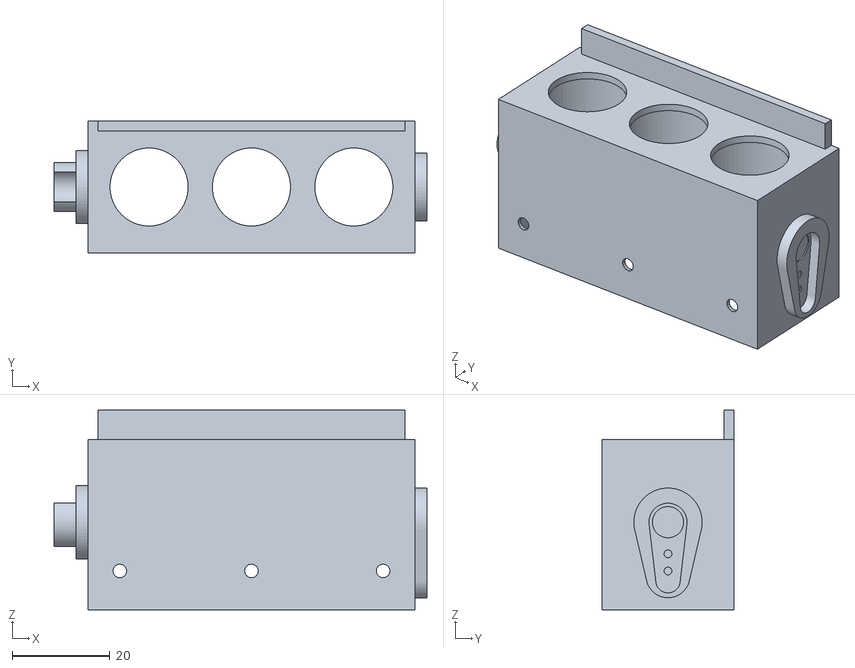
[picture p65: CAD file, 2026-10-22]
current/stl/lamp5_head.stl
76.5 x 27.0 x 41.0
