ic3e/Begode-master/current/stl/lamp5_drl_diffuser_x2.stl

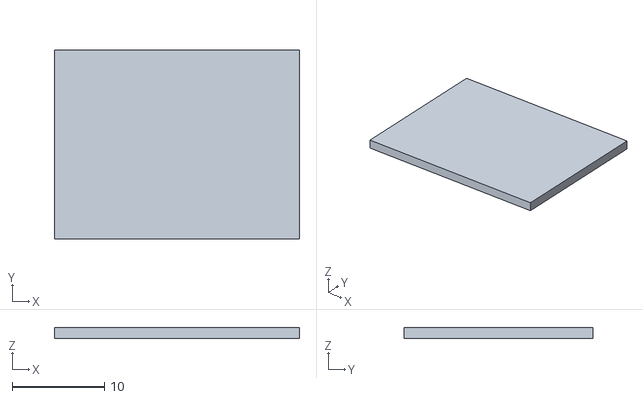
[picture p66: CAD file, 2026-10-22]
current/stl/lamp5_drl_diffuser_x2.stl
26.6 x 20.5 x 1.20
