ic3e/Begode-master/current/stl/lamp4_tray.stl

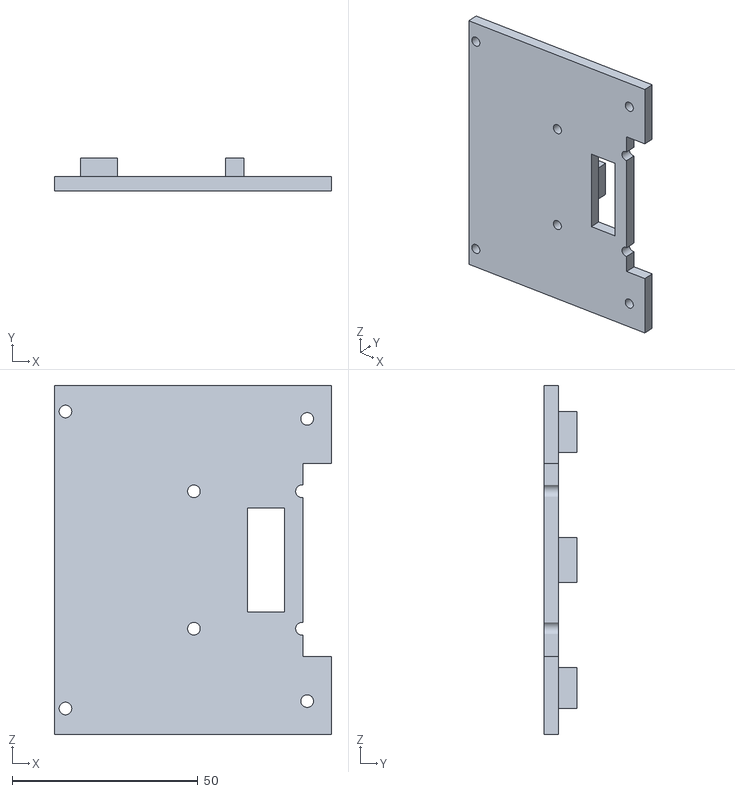
[picture p67: CAD file, 2026-10-22]
current/stl/lamp4_tray.stl
74.7 x 9.00 x 94.0
