ic3e/Begode-master/current/stl/lamp4_housing.stl

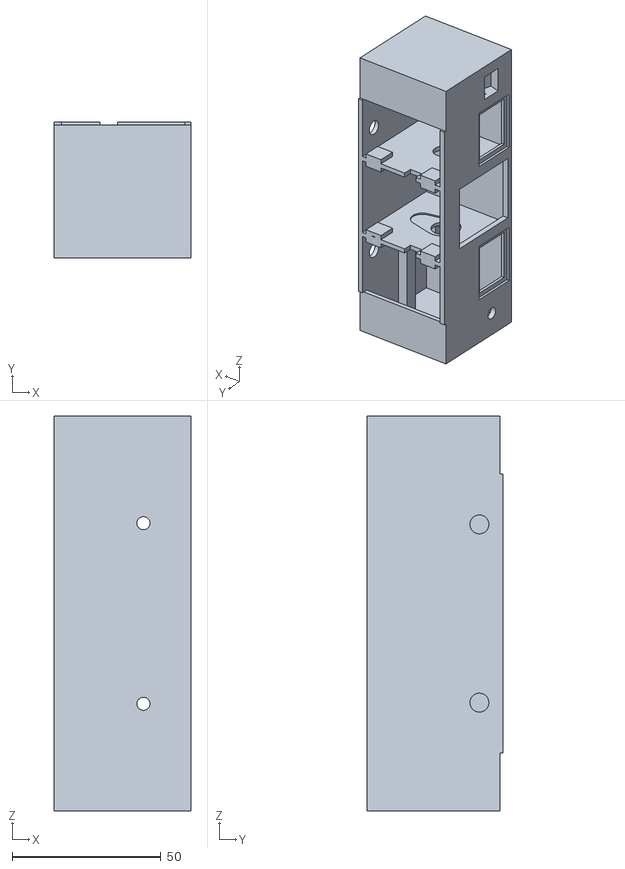
[picture p68: CAD file, 2026-10-22]
current/stl/lamp4_housing.stl
46.1 x 45.9 x 133.0
