ic3e/Begode-master/current/stl/lamp4_drl_diffuser_x2.stl

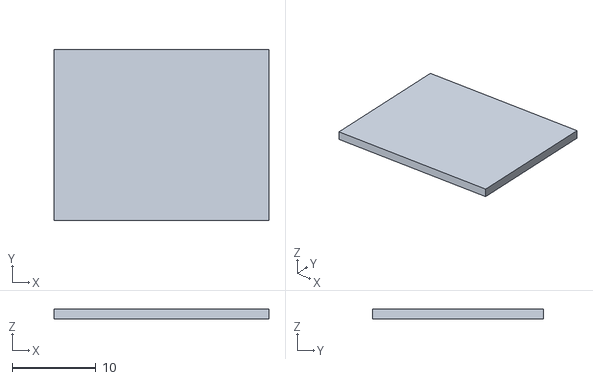
[picture p69: CAD file, 2026-10-22]
current/stl/lamp4_drl_diffuser_x2.stl
25.7 x 20.5 x 1.20
