ic3e/Begode-master/current/stl/cup4_swing_arm_left.stl

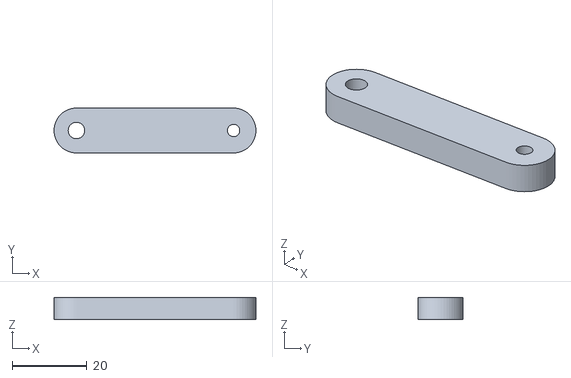
[picture p70: CAD file, 2026-10-22]
current/stl/cup4_swing_arm_left.stl
54.0 x 12.0 x 6.00
