ic3e/Begode-master/current/stl/lamp4_head.stl

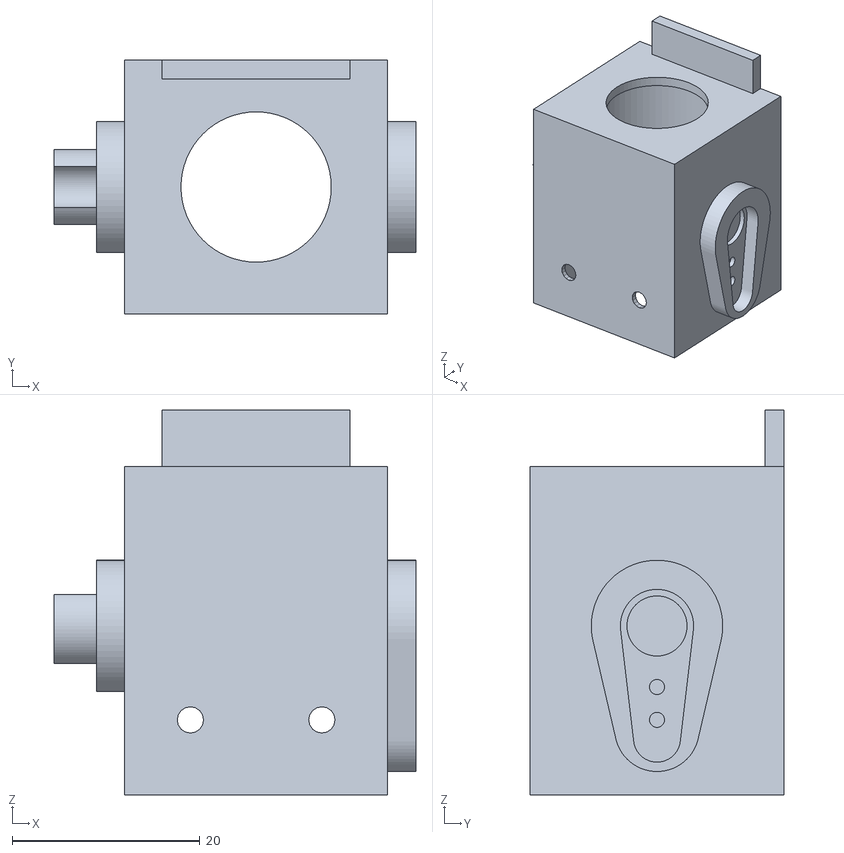
[picture p71: CAD file, 2026-10-22]
current/stl/lamp4_head.stl
38.5 x 27.0 x 41.0
