ic3e/Begode-master/(list of files, cad)

Other CAD files:
current/stl/master_handle_v18_right.stl
current/stl/lamp63_housing.stl
current/stl/master_handle_v17_usb_right.stl
current/stl/lamp62_housing.stl
current/stl/lamp61_lid.stl
current/stl/lamp61_top_plate.stl
current/stl/lamp54_top_plate.stl
current/stl/lamp53_head.stl
current/stl/lamp53_housing.stl
current/stl/lamp53_top_plate.stl
current/stl/lamp60_drl_diffuser_left.stl
current/stl/lamp51_lid.stl
current/stl/cup4_swing_arm_right.stl
archive/stl/cup2_gimbal_ring.stl
archive/stl/cup2_ring1.stl
archive/stl/cup2_ring2.stl
archive/stl/cup2_ring3.stl
archive/stl/cup2_ring4.stl
archive/stl/cup2_slide_arm_left.stl
archive/stl/cup2_slide_arm_right.stl
archive/stl/cup3_floor.stl
archive/stl/cup3_gimbal_ring.stl
archive/stl/cup3_ring.stl
archive/stl/cup3_swing_arm_left.stl
archive/stl/cup3_swing_arm_right.stl
archive/stl/cup4_swing_arm_right.stl
archive/stl/cup_gimbal_ring1.stl
archive/stl/cup_gimbal_ring2.stl
archive/stl/cup_gimbal_ring3.stl
archive/stl/cup_gimbal_ring4.stl
archive/stl/cup_holder_ring.stl
archive/stl/cup_holder_v2.stl
archive/stl/cup_ring_foot.stl
archive/stl/cup_ring_minimal.stl
archive/stl/cup_slide_arm_left.stl
archive/stl/cup_slide_arm_right.stl
archive/stl/cupholder_v3_basket.stl
archive/stl/cupholder_v3_plate.stl
archive/stl/cupholder_v3_ring.stl
archive/stl/cupholder_v4_basket.stl
archive/stl/cupholder_v4_plate.stl
archive/stl/cupholder_v4_ring.stl
archive/stl/cupholder_v5_plate.stl
archive/stl/cupholder_v5_ring.stl
archive/stl/cupholder_v5_tray.stl
archive/stl/headlamp2_drl_diffuser_x2.stl
archive/stl/headlamp2_electronics_block.stl
archive/stl/headlamp2_lid.stl
archive/stl/headlamp2_servo_block.stl
archive/stl/headlamp3_cup_ring.stl
archive/stl/headlamp3_cup_tray.stl
archive/stl/headlamp3_electronics_block_leg.stl
archive/stl/headlamp3_servo_block_leg.stl
archive/stl/headlamp_electronics_block.stl
archive/stl/headlamp_head.stl
archive/stl/headlamp_lid.stl
archive/stl/headlamp_servo_block.stl
archive/stl/lamp51_lid.stl
archive/stl/lamp53_head.stl
archive/stl/lamp53_housing.stl
archive/stl/lamp53_top_plate.stl
archive/stl/lamp54_top_plate.stl
archive/stl/lamp60_drl_diffuser_left.stl
archive/stl/lamp61_lid.stl
archive/stl/lamp61_top_plate.stl
archive/stl/lamp62_housing.stl
archive/stl/lamp63_housing.stl
archive/stl/master_handle_cupside_A.stl
archive/stl/master_handle_cupside_B.stl
archive/stl/master_handle_v10.stl
archive/stl/master_handle_v11.stl
archive/stl/master_handle_v13_usb_left.stl
archive/stl/master_handle_v13_usb_right.stl
archive/stl/master_handle_v14_usb_left.stl
archive/stl/master_handle_v14_usb_right.stl
archive/stl/master_handle_v15_usb_left.stl
archive/stl/master_handle_v15_usb_right.stl
archive/stl/master_handle_v16_usb_left.stl
archive/stl/master_handle_v16_usb_right.stl
archive/stl/master_handle_v17_usb_right.stl
archive/stl/master_handle_v2.stl
archive/stl/master_handle_v3_lamp_cup.stl
archive/stl/master_handle_v4_lamp_cup.stl
archive/stl/master_handle_v5_lamp_cup.stl
archive/stl/master_handle_v6.stl
archive/stl/master_handle_v7.stl
archive/stl/master_handle_v8.stl
archive/stl/master_handle_v9.stl
archive/stl/rough_stock_lamp.stl
current/stl/master_handle_bolt_cover_left.stl
current/stl/master_handle_bolt_cover_right.stl
current/stl/master_handle_v11.stl
current/stl/master_handle_v13_usb_left.stl
current/stl/master_handle_v13_usb_right.stl
current/stl/master_handle_v14_usb_left.stl
current/stl/master_handle_v14_usb_right.stl
current/stl/master_handle_v15_usb_left.stl
current/stl/master_handle_v15_usb_right.stl
current/stl/master_handle_v16_usb_left.stl
current/stl/master_handle_v16_usb_right.stl
