ic3e/Begode-master/current/renders/print_bolt_covers.png

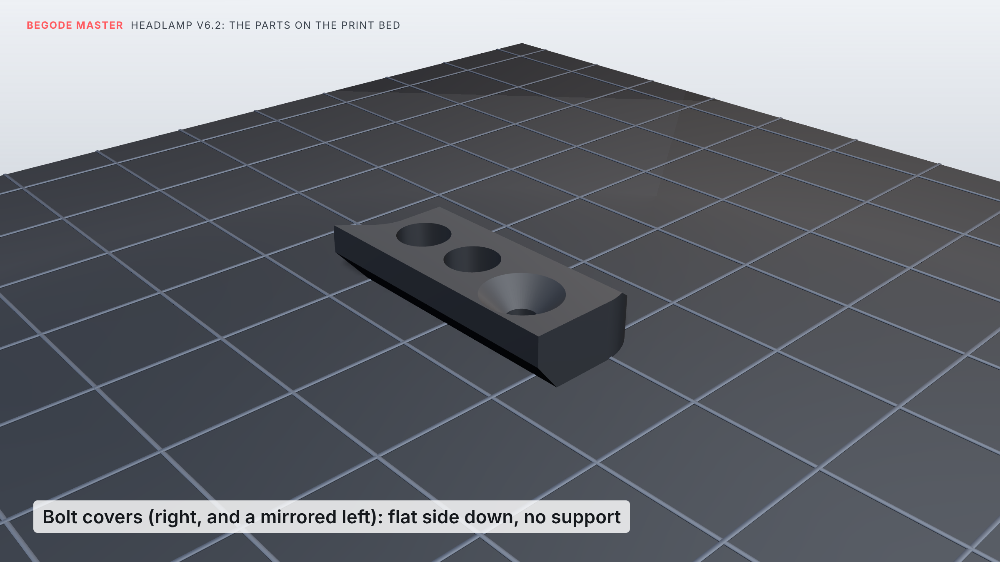
current/renders/print_bolt_covers.png
