ic3e/Begode-master/current/renders/print_handle.png

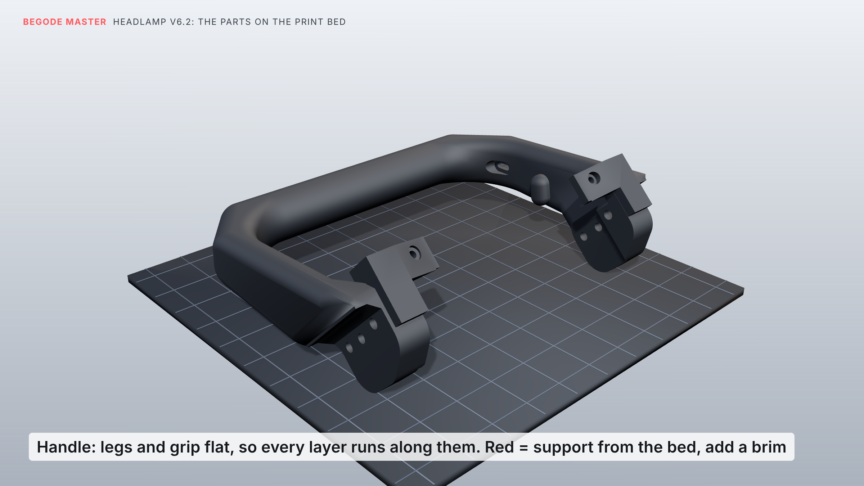
current/renders/print_handle.png
