ic3e/Begode-master/current/renders/print_handle_supports.png

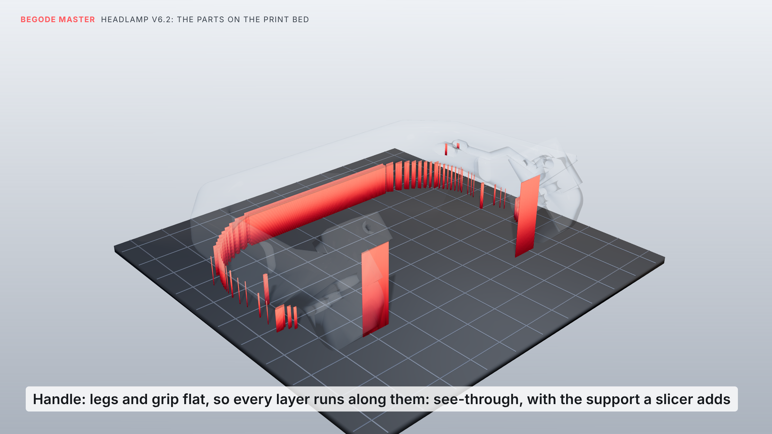
current/renders/print_handle_supports.png
