ic3e/Begode-master/current/renders/print_housing.png

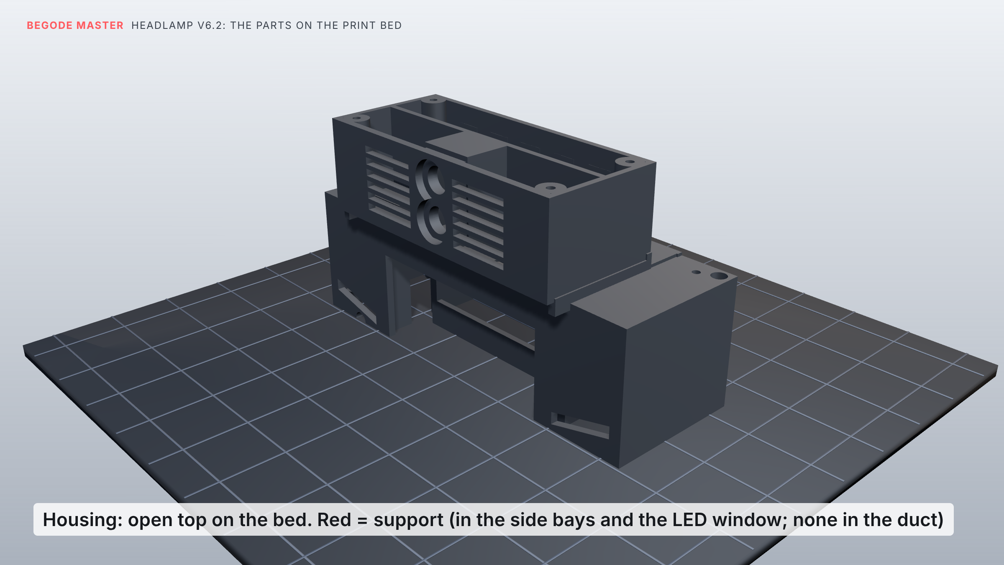
current/renders/print_housing.png
