ic3e/Begode-master/current/renders/print_lens_frame.png

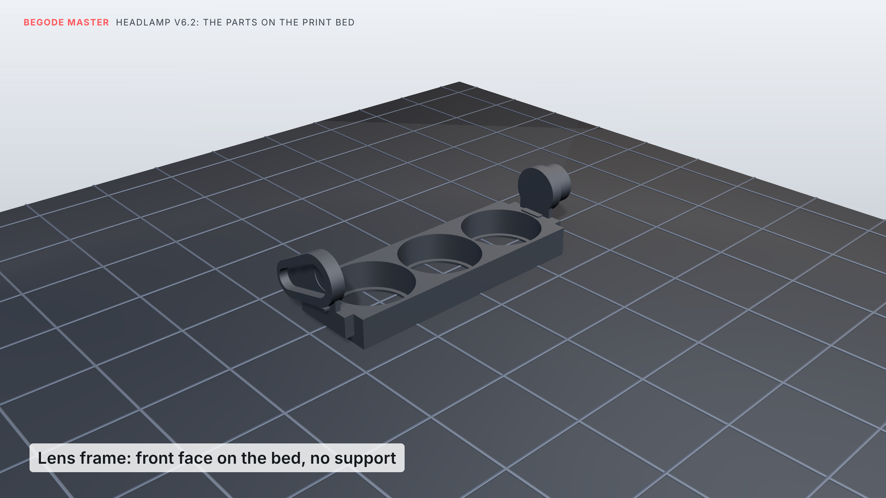
current/renders/print_lens_frame.png
