ic3e/Begode-master/current/renders/print_lid.png

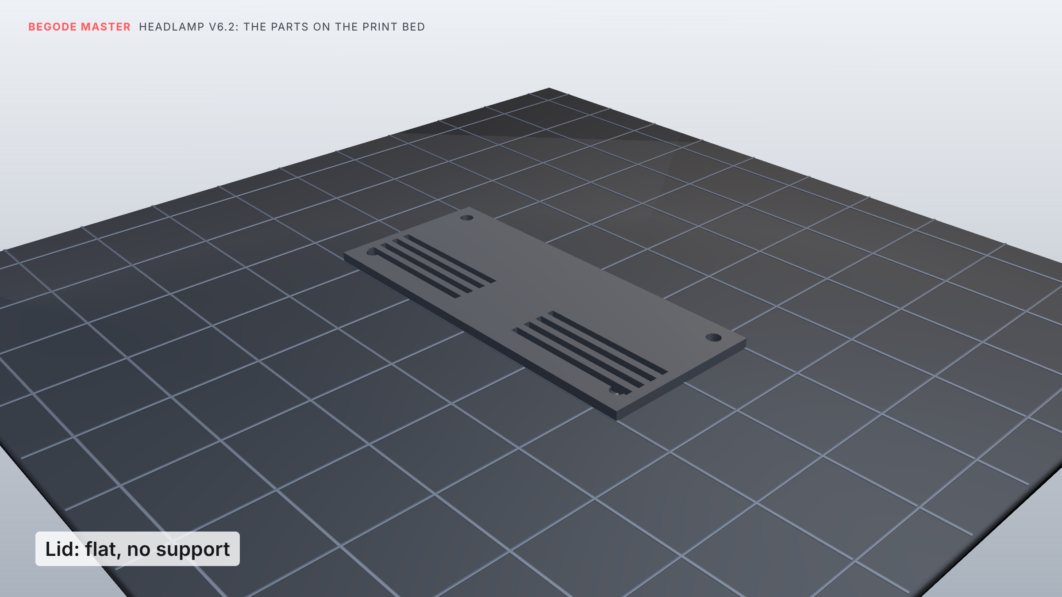
current/renders/print_lid.png
