ic3e/Begode-master/current/renders/print_top_plate.png

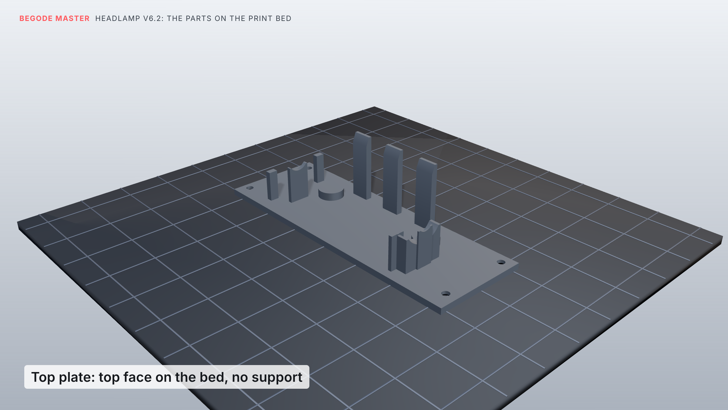
current/renders/print_top_plate.png
