ic3e/Begode-master/reference/measurements_lamp_space.png

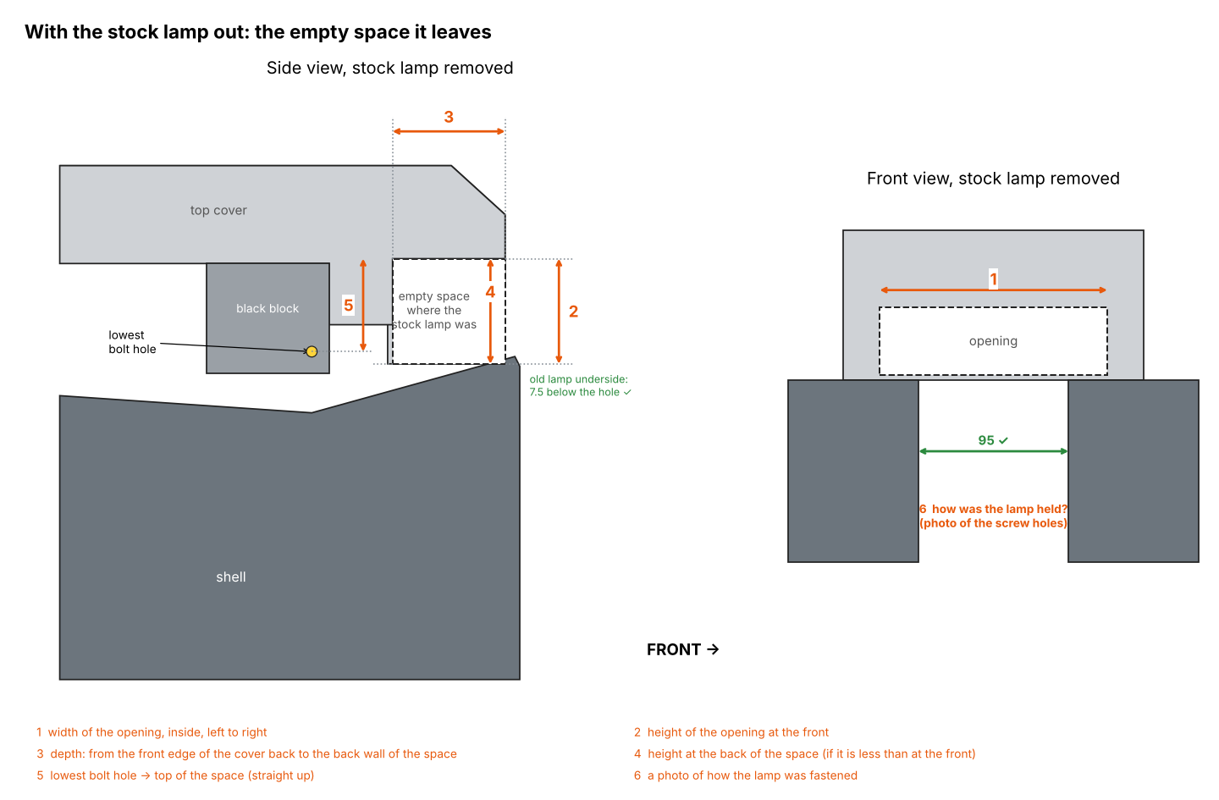
reference/measurements_lamp_space.png
