ic3e/Begode-master/reference/measurements_needed.png

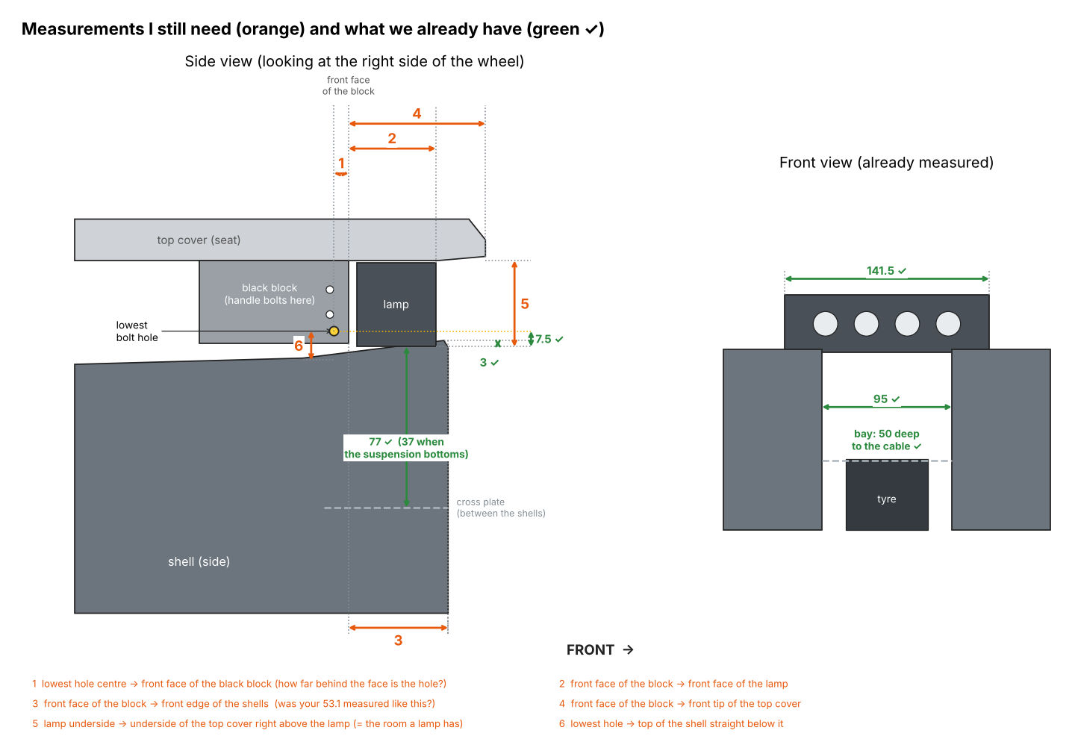
reference/measurements_needed.png
