ic3e/Begode-master/source/check_foot.py

exec(open('build12.py').read().split("\nif __name__=='__main__':")[0]+open('build12.py').read().split("    to_tm(c7(ring)).export('v7_cup_open.stl'); to_tm(c7(pose(ring,PIN0,-90))).export('v7_cup_folded.stl')")[1])
handle=to_mf(trimesh.load(U+'euc_master_front_handle.stl'))+holder7()
sb=servo_block2(); eb=elec_block2(); ld=lid2(); hd=H(head()); sv=H(servo_model()[0])
fixed=handle+sb+eb+ld+sv+diffuser(1)+diffuser(-1)
ring=ring_with_pilots(); foot=foot_local()
print('foot folding against the ring:',[(d,round((foot_pose(foot,d)^ring).volume(),2)) for d in range(0,91,15)])
fd=foot_pose(foot,0); ff=foot_pose(foot,90)
print('open ring + foot down vs fixed:',round((c7(fd)^fixed).volume(),2))
assy=lambda pin,deg: c7(pose(ring+ff,pin,deg))
print('ring+folded foot, locked:',round((assy(PIN0,0)^fixed).volume(),2))
print('  slide to unlock:',[round((assy(PIN0+(PIN1-PIN0)*t,0)^fixed).volume(),2) for t in (0.25,0.5,0.75,1)])
print('  fold down:',[(d,round((assy(PIN1,-d)^fixed).volume(),2)) for d in range(0,91,15)])
print('  hanging:',round((assy(PIN0,-90)^fixed).volume(),2))
cone=mf.Manifold.cylinder(2600,0.5,2600*np.tan(np.radians(8.5)),48).rotate([0,90,0])
cone=cone.rotate([0,0,180+TOF_DOWN]).translate([BX0-4,TOF_Y,ZC+TOF_W])^box(-3000,-60,-679+5,300,-400,300)
print('road sensor view vs foot down / folded:',round((cone^c7(fd)).volume(),1),round((cone^assy(PIN0,-90)).volume(),1))
for a in (-13,13): print('head',a,'vs foot down:',round((tilt(hd,a)^c7(fd)).volume(),2))
t=to_tm(foot); print('foot watertight',t.is_watertight,'bodies',len(t.split(only_watertight=False)))
t=to_tm(ring); print('ring watertight',t.is_watertight,'bodies',len(t.split(only_watertight=False)))
bb=c7(fd).bounding_box(); print('foot crossbar top Y',round(bb[1]+3,1),' ring top Y',round(c7(ring).bounding_box()[4],1))
hb=assy(PIN0,-90).bounding_box(); print('folded pack: X',round(hb[0]),'..',round(hb[3]),' thickness',round(hb[3]-hb[0]),' bottom Y',round(hb[1]))
# exports
b0=ring.bounding_box(); to_tm(ring.translate([0,0,-b0[2]])).export(OUT+'cup_ring_minimal.stl')
f=foot; b0=f.bounding_box(); to_tm(f.translate([0,0,-b0[2]])).export(OUT+'cup_ring_foot.stl')   # crossbar side down
to_tm(c7(ring+fd)).export('v7b_cup_open.stl'); to_tm(assy(PIN0,-90)).export('v7b_cup_folded.stl')
