ic3e/Begode-master/source/export22.py

exec(open('build22.py').read())
import glob, os
os.makedirs(OUT,exist_ok=True)
def flat(m): b=m.bounding_box(); return m.translate([-(b[0]+b[3])/2,-(b[1]+b[4])/2,-b[2]])
to_tm(handle13(1)).export(OUT+'master_handle_v13_usb_right.stl')
to_tm(handle13(-1)).export(OUT+'master_handle_v13_usb_left.stl')
to_tm(flat(housing9().rotate([-90,0,0]))).export(OUT+'lamp60_housing.stl')            # open top on the bed
to_tm(flat(top_plate9().rotate([-90,0,0]))).export(OUT+'lamp60_top_plate.stl')        # top face on the bed, tongues up
to_tm(flat(lens_frame().rotate([0,90,0]))).export(OUT+'lamp60_lens_frame.stl')        # front on the bed
to_tm(flat(lid9().rotate([90,0,0]))).export(OUT+'lamp60_lid.stl')
to_tm(flat(gasket9().rotate([90,0,0]))).export(OUT+'lamp60_gasket_TPU.stl')
to_tm(flat(bar_clamp().rotate([0,90,0]))).export(OUT+'lamp60_bar_clamp.stl')
to_tm(flat(diffuser5(1).rotate([0,90,0]))).export(OUT+'lamp60_drl_diffuser_right.stl')
to_tm(flat(diffuser5(-1).rotate([0,90,0]))).export(OUT+'lamp60_drl_diffuser_left.stl')
pts=window_outline(); W_=2*WIN_W; H_=WIN_Y1-WIN_Y0
path=' '.join(('M' if i==0 else 'L')+f'{w+WIN_W:.2f},{WIN_Y1-y:.2f}' for i,(w,y) in enumerate(pts))+' Z'
open(OUT+'lamp60_window_1.5mm_polycarbonate.svg','w').write(
 f'<svg xmlns="http://www.w3.org/2000/svg" width="{W_:.1f}mm" height="{H_:.1f}mm" viewBox="0 0 {W_:.2f} {H_:.2f}">'
 f'<path d="{path}" fill="none" stroke="black" stroke-width="0.2"/></svg>')
open(OUT+'lamp60_sensor_window_1mm_polycarbonate.svg','w').write(
 '<svg xmlns="http://www.w3.org/2000/svg" width="13.6mm" height="14.0mm" viewBox="0 0 13.6 14.0">'
 '<rect x="0.1" y="0.1" width="13.4" height="13.8" fill="none" stroke="black" stroke-width="0.2"/></svg>')
for f in sorted(glob.glob(OUT+'lamp60_*.stl')+glob.glob(OUT+'master_handle_v13_*.stl')):
    t=trimesh.load(f); print(f.split('/')[-1],'watertight',t.is_watertight,'bodies',len(t.split(only_watertight=False)),'size',np.round(t.extents,1))
