ic3e/Begode-master/(commit log)

2026-10-22 Begode Master front handle, self-levelling lamp and can holder
    Moves the whole project here from the design session: the current build (handle v11 with the
    self-levelling lamp in the stock lamp opening and the swing-up can holder), its firmware, guide,
    renders and animation; every earlier version under archive/; the original handle and cap STLs and
    all caliper measurements under reference/; and the scripts that build, check, export and render
    each version under source/, with paths made relative so they run from the repo.
    Claude-Session: https://claude.ai/code/session_01ME7RBQxSCw2tM9mBsSts5A
    [cup2_gimbal_ring.stl, cup2_ring1.stl, cup2_ring2.stl, cup2_ring3.stl, cup2_ring4.stl, cup2_slide_arm_left.stl, cup2_slide_arm_right.stl, cup3_floor.stl]
2026-10-22 Lamp v5: three-LED self-levelling headlamp, no can holder
    The can holder is dropped. The lamp in the stock opening now carries three LEDs on one finned bar
    that the servo tilts ±10° (about 1200 lm at the default 90 %), with the electronics in a box that hangs
    into the bay between the shells and opens from below. Handle v12 is the original handle plus two webs
    back to its tabs; the lamp screws to those and to the cover's two M4 screws (via heat-set inserts).
    Firmware v5 runs the three LDD-1500L from one DIM pin and defaults the beam to 90 % so the lamp stays
    within the wheel's lamp output. v8 (with the can holder) and its animation move to archive/.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
    [cup3_floor.stl, cup3_gimbal_ring.stl, cup3_ring.stl, cup4_swing_arm_left.stl, cup4_swing_arm_right.stl, lamp4_drl_diffuser_x2.stl, lamp4_head.stl, lamp4_housing.stl]
2026-10-22 Parts list with prices and shops; Estonian build guide and parts list
    PARTS.md lists every part for lamp v5 with rough prices (about €75–110, or €60–90 with PT4115 drivers)
    and where to get them in Finland, Estonia and the EU, and notes that the Mean Well LDD-1500L is
    discontinued. BUILD_GUIDE_et.md and PARTS_et.md are the Estonian versions.
    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
2026-10-22 Lamp v5.1: flush window, angled running lights, drop-checked
    The lamp now looks like part of the Master rather than something added to it:
    - a clear 1.5 mm polycarbonate window sits flush in the stock opening over a black face;
    - the running lights are two angled light lines that follow the shells' facets;
    - the visor is gone, since the window does its job.
    With the front sealed, air comes in through a chin vent under the lamp, passes the heat sink and leaves
    behind a baffle through the box's back slots.
    A new drop check tries about 18,000 fall directions against the measured wheel and handle. In every one
    the handle grip, the shells or the tyre touch the ground first, and the lamp stays a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
    [lamp51_drl_diffuser_left.stl, lamp51_drl_diffuser_right.stl, lamp51_head.stl, lamp51_housing.stl, lamp51_lid.stl, lamp5_drl_diffuser_x2.stl, lamp5_head.stl, lamp5_housing.stl]
2026-10-22 Parts list: the filament is already in the total, not on top of it
    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
2026-10-22 Lamp v5.2: a housing the head and servo can actually go into
    v5.1's housing was one closed print, and its head couldn't be fitted. At 72 mm across, it couldn't get in
    past the electronics box from below or through the 68 mm light opening. The pivot pin and the servo shaft
    sat in closed round holes, and the servo's tab screws pointed into a 6 mm gap no screwdriver reaches.
    Now the housing is open on top and a 3 mm top plate closes it:
    - The head and servo are joined on the bench and go in from above as one unit: the pin into a slot in the
    left wall (now a 4 mm bearing), the shaft into a slot in the right wall, the tabs into slots in the
    servo's two posts.
    - The plate's tongues fill those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
    [lamp51_drl_diffuser_left.stl, lamp51_drl_diffuser_right.stl, lamp51_head.stl, lamp51_housing.stl, lamp51_lid.stl, lamp52_drl_diffuser_left.stl, lamp52_drl_diffuser_right.stl, lamp52_head.stl]
2026-10-22 Lamp v5.3: a sealed ball bearing for the head's pivot
    A printed pin turning in a printed hole works on load (friction is a few % of the servo's torque), but it
    binds if the print comes out tight, grinds with dust from the chin vent, and wears into play that makes
    the beam shiver over bumps.
    - A sealed 6800-2RS (10 x 19 x 5) now presses onto the 10 mm pin, against a new shoulder.
    - Its outer ring drops into a seat in a 6 mm block in the left wall, behind a lip that touches only the
    outer ring.
    - The top plate's tongue holds it down.
    The wire hole ran 2.7 mm off the pin's axis and broke out of the pin's side as an open groove. It now runs
    on the axis and meets the hole to the stars inside t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
    [lamp52_drl_diffuser_left.stl, lamp52_drl_diffuser_right.stl, lamp52_head.stl, lamp52_housing.stl, lamp52_lid.stl, lamp52_top_plate.stl, lamp53_drl_diffuser_left.stl, lamp53_drl_diffuser_right.stl]
2026-10-22 Lamp v5.4 + handle v13: head stops, chin buttons, USB-C charger; test plan
    Durability first:
    - A lug on the head now meets stops at ±12°, one on the housing and one a finger of the top plate, so the
    head still drops in from above. When the wheel lands hard, the head's weight goes into the stops, not into
    the servo's small gears. The firmware keeps to ±10° and the trim to ±1.5°, so the servo never pushes on
    them.
    - TESTING.md: bench, rides, rough roads, drops stepped up from grass to asphalt, rain, and a log to fill in.
    No phone needed:
    - Two sealed 8 mm buttons sit one above the other in the middle of the chin, so either hand reaches them.
    They're recessed in pockets, and the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
    [lamp53_drl_diffuser_left.stl, lamp53_drl_diffuser_right.stl, lamp53_head.stl, lamp53_housing.stl, lamp53_lid.stl, lamp53_top_plate.stl, lamp54_drl_diffuser_left.stl, lamp54_drl_diffuser_right.stl]
2026-10-22 Lamp v6: sealed against rain, tyre spray and sand
    The tyre sits a few cm under the lamp and throws water and sand up at it even on a merely wet road. In v5
    the cooling air passed the servo, the lenses and the electronics, because the heat sink was part of the
    tilting head. A splash trap would have stopped the water but not the sand.
    Now the LEDs no longer tilt. The three stars stay on the heat-sink bar (cut to 62 mm), which is clamped
    behind a bulkhead:
    - its face and the LEDs are on the dry side, sealed with silicone;
    - its fins sit in a duct of their own;
    - a frame with only the three lenses tilts, on the same bearing and servo, about the line through the LED
    chips, so the beam follows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
    [lamp54_drl_diffuser_left.stl, lamp54_drl_diffuser_right.stl, lamp54_head.stl, lamp54_housing.stl, lamp54_lid.stl, lamp54_top_plate.stl, lamp60_bar_clamp.stl, lamp60_drl_diffuser_left.stl]
2026-10-22 Lamp v6.1: fewer parts
    "The best part is no part."
    - No road sensor. Under the lamp its window would be dirty with spray and sand most of the time. The gyro
    and accelerometer still cancel braking, accelerating and bumps and follow long hills partly. Its window,
    pocket and cable hole go, the chin gets its full air intake back, and the firmware needs no extra
    library.
    - No bar clamp. Three fingers on the top plate drop in behind the fins and hold the LED bar against the
    bulkhead.
    - No diffusers. The running-light strips shine through their slots; the window's inside is sanded over
    - No TPU gasket. The window's foam tape, laid on the electronics box's wall edges, seals the lid,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
    [lamp60_bar_clamp.stl, lamp60_drl_diffuser_left.stl, lamp60_drl_diffuser_right.stl, lamp60_gasket_TPU.stl, lamp60_housing.stl, lamp60_lens_frame.stl, lamp60_lid.stl, lamp60_top_plate.stl]
2026-10-22 Renders: lamp v6.1 on a Master dressed from the owner's photos
    The exterior stills now show lamp v6.1 (window over the running-light slots, + and - under the chin) on a
    wheel that looks like the Master: faceted side pads, the silver suspension rail over the axle, the rear
    battery pack, a knobby tyre and spoked rim, spiked pedals, fender, red rear linkage and tail light, traced
    from the 360 turntable GIF. It is dressed over the measured outline, so the fit checks are unchanged and the
    fallen-forward gap still reads 25 mm. The v5.1 stills move to archive/.
    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
2026-10-22 Renders: put the black controller block back under the handle
    The dressed wheel model left the block out, so in the fallen-forward cut the handle's foot looked like it
    hung in the air. Its three bolts go sideways into the block's sides, and now the block is drawn behind them.
    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
2026-10-22 Lamp v6.2: STLs ready for the slicer
    Checked every STL the way a slicer sees it (new print_check.py: closed solids, walls the nozzle can draw,
    floors of at least a layer, slits, and what needs support and where it stands), and fixed what it found:
    - Lens frame: the horn pocket's floor was 0.3-0.5 mm and the horn's screws had nothing to bite in. The floor
    is now 1.2 mm, swinging in a 0.4 mm recess in the pocket wall; the horn is glued. Prints face down.
    - Housing: a 0.05 mm skin from the old stop, slits beside the lower stop, the bar pads and the handle-screw
    bosses. Ribs in the duct so the sealed slabs over and under it bridge instead of needing support that
    could never come out; cones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
    [lamp61_housing.stl, lamp61_lens_frame.stl, lamp61_lid.stl, lamp61_top_plate.stl, lamp62_housing.stl, lamp62_lens_frame.stl, lamp62_lid.stl, lamp62_top_plate.stl]
2026-10-22 Handle v15: USB-C port flush in the leg, no bump
    The IP67 panel socket is 26 mm long behind its flange and the leg is 18 mm thick, so v13/v14 carried it in a
    round boss sticking into the handle's opening. v15 takes a bare 6-pin USB-C receptacle (8.9 x 3.3 mm shell)
    in a slot behind a shallow recess in the leg's flat outer face, where the old socket was. It goes in from a
    pocket on the leg's inner face, which is then filled with epoxy; a silicone dust plug closes the port. The
    wire channel starts in the pocket and follows v14's path. Walls round the pocket are 9 mm or more; the
    handle clears the wheel and the lamp; print check clean. Build guide, parts list, test plan and renders
    updated (new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
    [master_handle_v14_usb_left.stl, master_handle_v14_usb_right.stl, master_handle_v15_usb_left.stl, master_handle_v15_usb_right.stl]
2026-10-22 Handle v16: USB-C port on the inside of the leg, pressed in from inside
    On the leg's outer face the port is what hits the ground when the wheel falls on its side. Facing into the
    handle's opening, the leg's outer face takes it instead. The receptacle presses into a tight slot from the
    inside, wires and resistors going ahead of it into a small chamber and the channel, so there is no pocket to
    fill with epoxy; a ring of silicone seals its edge. The plug goes straight in, into a rounded well in the
    slanted face: tilted square to the face, the cable ran into the cover; straight in, a plug up to 50 mm long
    clears the cover, lamp and wheel. 3.9 mm of leg stays behind the chamber on the outer face;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
    [master_handle_v15_usb_left.stl, master_handle_v15_usb_right.stl, master_handle_v16_usb_left.stl, master_handle_v16_usb_right.stl]
2026-10-22 Handle v17: lamp tabs braced with gussets
    The first printed handle snapped both lamp tabs at the root, where they leave the leg: a 4 mm plate bending
    about that line, and on the USB side the wire's groove ran right along the root and cut it to 1.8 mm. v17
    keeps the 4 mm tabs and adds a triangular gusset under each (5 mm deep at the root, tapering out under the
    screw, 2 mm off the shells), fills the gap between the tab's end and the leg so the gusset braces against
    the leg, and adds a sloped fillet over the root outside the lamp's side wall. The USB wire now runs in a
    closed channel through that root and comes up through the tab under the housing's grommet. The screws get
    counterbores, so the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
    [master_handle_v16_usb_left.stl, master_handle_v16_usb_right.stl, master_handle_v17_usb_left.stl, master_handle_v17_usb_right.stl]
2026-10-22 Build guide: the USB wire now ends at the lamp tab, not the foot
    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
2026-10-22 Bolt covers for both handle feet
    The stock bolt cover / fixing plate (euc_master_front_handle_p2) covers the right foot's three bolts; the left
    foot needs its mirror. Both are exported now, flat side down (master_handle_bolt_cover_right / _left), checked
    against the v17 handle (they sit in the feet's recesses without overlapping) and the wheel; print check clean.
    Build guide's parts table and handle step, README, print preview and stills updated.
    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
    [master_handle_bolt_cover_left.stl, master_handle_bolt_cover_right.stl]
2026-10-22 Build guide: the knobs inside the handle's legs hold the top cover's edge
    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
2026-10-23 Lamp v6.3: boards placed, wire slots, wiring diagram and board renders
    Fitted every board at its real size into the dry spaces (boards_pack.py, around the housing, plate, servo,
    bearing, LED bar and the lens frame's whole swing). Everything fits, with two changes: the MPU-6050 goes flat
    on top of the left bay (the electronics box is only 16 mm deep front to back), and the MOSFET modules must
    be small AO3400 ones (the D4184 boards with screw terminals don't fit beside the servo); the INA219 stands
    next to the ESP32 in the electronics box. The left bay reached the box only through 2 mm gaps, so each side
    bay's floor gets a slot into the box (2.3 x 10 mm left, beside the bearing block; 5 x 10 m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
    [lamp62_housing.stl, lamp62_lens_frame.stl, lamp62_lid.stl, lamp62_top_plate.stl, lamp63_housing.stl, lamp63_lens_frame.stl, lamp63_lid.stl, lamp63_top_plate.stl]
2026-10-23 Renders: how far the lenses tilt, and the beam held level on the wheel
    Cut close-ups of the lens frame at -12, 0 and +12 deg (the stops sit at +-12.4; the firmware uses +-10), and
    the wheel at night riding level, braking nose 10 deg down and accelerating 8 deg nose-up, with the levelled beam
    and a fixed lamp's beam in red for comparison. Build guide: a short "How far it levels" section with what the
    angles mean on the road (lenses 0.61 m up; 1 deg is 35 cm at 20 m).
    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
    [swing_export.py]
2026-10-23 Rider's view at night: the levelled lamp against a fixed one, animated
    pov_export.py and anim/pov.html: standing on the wheel on a night road, through cruising, hard braking
    (nose 9 deg down), accelerating (nose 7 deg up) and broken asphalt. The lamp lights the road as three
    spots, one per optic; the lenses move by the firmware's rule (aim 2 deg down minus the pitch, +-10,
    400 deg/s, 0.25 deg deadband) and the inset rides the same with them fixed.
    renders/rider_pov.mp4 (and .gif, .png); build guide and source README point to them.
    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
    [pov_export.py]
2026-10-23 Lamp v6.4 + handle v18: the beam follows hills, and dips for others
    Hills: an EUC balances to gravity, not to the road, so on a steady hill the shell
    stays level and the gyro sees nothing; v6.1-v6.3's "follow hills" only followed the
    pedal angle. A VL53L1X (Pololu carrier) now sits in a hood behind the left of the
    face and looks 25 deg down through the main window at the road about 1.3 m ahead.
    The firmware turns its distance and the wheel's pitch into the slope the wheel is
    on (median of five, about 1 s smoothing, back to plain levelling when it loses the
    road) and tips the beam by it. Calibrating on flat ground also measures the
    sensor's real angle. The LED drivers move back about 8 mm to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
    [lamp63_housing.stl, lamp63_lens_frame.stl, lamp63_lid.stl, lamp63_top_plate.stl, lamp64_housing.stl, lamp64_lens_frame.stl, lamp64_lid.stl, lamp64_top_plate.stl]
2026-10-23 Concept renders: a cut-off of our own, the projector bench rig
    The stock opening is too short for a ready-made cut-off lens, so the way to a flat-topped
    beam is a projector, as in a car's low beam: a blade's straight edge across the middle of
    the LED's chip and a glass aspheric lens focused on it. proj_export.py draws the bench rig
    (one LED on a heat sink, a printed jig with a blade slot and height screw, a focus sleeve
    for the lens), cut open, as printed, and at night against a wall, where the beam's top is
    a sharp line under the lamp-height tape. A picture, not built or checked yet.
    Claude-Session: https://claude.ai/code/session_01ME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
    [proj_export.py]
